Govish/FusIon-Pack/README.md

# FusIon-Pack
Design files and documentation for the FusIon Battery Pack
