Govish/FusIon-Pack/REV 0-1 PCB/Renderings/Front 3-4 Pre Silk 2-18.png

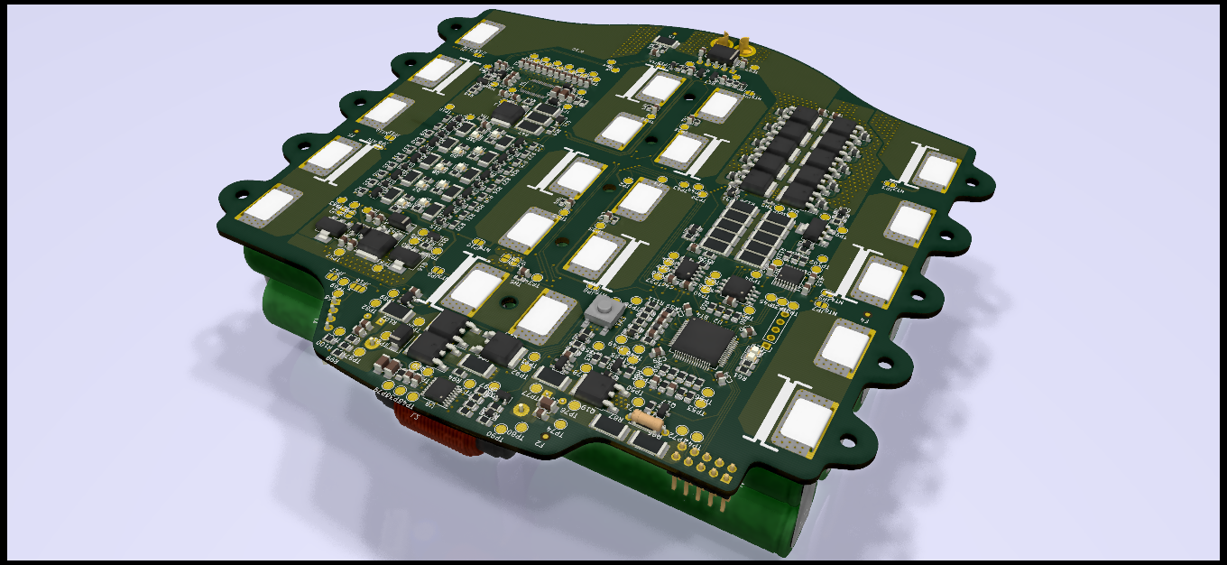
REV 0-1 PCB/Renderings/Front 3-4 Pre Silk 2-18.png
