Govish/FusIon-Pack/Bill of Materials/FusIon Pack.xlsx

Designator | Package | Quantity | Price @Break | Total Price | Value | Manufacturer | Part Number | Supplier and ref | Notes For Substitution
R78 | 1/4W Axial | 1 |  | $0.00 | DNP |  | - | - | Axial Resistor for alternative LED Button Voltage
R88 | 0805 | 1 |  | $0.00 | R |  | - | - | Compensation resistor, will figure out value
R94 | 0805 | 1 |  | $0.00 | 15R |  | - | - | Opt. Gate resistor for boost converter, pretty much anything tbh
C50, C51 | 1206 | 2 |  | $0.00 | C |  |  | - | Compensation capacitors, will figure out value
BT1, BT2, BT3, BT4, BT5, BT6, BT7, BT8, BT9, BT10 | Battery_18650_Cell_Pair | 10 | $8.50 | $85.00 | VTC4 | Sony | US18650VTC4 | 18650 Battery Store (https://www.18650batterystore.com/Sony-18650-p/sony-vtc4.htm) | Another VTC4 Supplier (e.g. IMR Batteries) (https://www.imrbatteries.com/murata-vtc4-18650-2100mah-30a-battery/)
C13, C14, C23, C24, C58, C62, C31 | 0805 | 7 | $0.50 | $3.50 | 1u | TDK Corporation | C2012X7S2A105K125AE | DigiKey (https://www.digikey.com/product-detail/en/tdk-corporation/C2012X7S2A105K125AE/445-8887-1-ND/3283749) | >=75V, X7R+ Rating preferrable (X5R probably would work)
C15, C16, C25, C26, C33, C35, C36, C37, C38, C39, C40, C41, C48, C59, C61, C63 | 0805 | 16 | $0.04 | $0.69 | 10n | Wurth Electronics | 885342207005 | DigiKey (https://www.digikey.com/product-detail/en/wurth-electronics-inc/885342207005/732-12105-1-ND/9346125) | >=75V, X7R+ Rating preferrable (X5R probably would work)
C17, C18, C1, C2, C3, C4, C5, C6, C7, C8, C9, C10, C11, C12, C21, C28, C29, C30, C32, C42, C43, C46, C47, C49, C53, C55, C60, C64, C65, C66, C67 | 0805 | 31 | $0.06 | $1.92 | 100n | Samsung Electro-Mechanics | CL21B104KBFNNNE | DigiKey (https://www.digikey.com/product-detail/en/samsung-electro-mechanics/CL21B104KBFNNNE/1276-1180-1-ND/3889266) | >50V, X7R+ Rating preferrable (X5R probably would work)
C19, C20, C54 | 1206 | 3 | $0.57 | $1.71 | 10u | Murata | GRT31CR61H106ME01L | DigiKey (https://www.digikey.com/product-detail/en/murata-electronics-north-america/GRT31CR61H106ME01L/490-12457-1-ND/5417158) | 35V absolute minimum, >=50V preferrable; X7R+ Rating preferrable (X5R possible?)
C22, C27, C34, C44, C45, C56 | 0805 | 6 | $0.13 | $0.78 | 4.7u | Samsung Electro-Mechanics | CL21A475KPFNNNE | DigiKey (https://www.digikey.com/product-detail/en/samsung-electro-mechanics/CL21A475KPFNNNE/1276-1259-1-ND/3889345) | >=10V abs min, X7R+ Rating preferrable (X5R probably would work)
C52, C57 | CP_Radial_D8.0mm_P3.50mm_H13.0mm | 2 | $2.60 | $5.20 | 33u | Nichicon | RNU1J330MDN1KX | DigiKey (https://www.digikey.com/product-detail/en/nichicon/RNU1J330MDN1KX/493-6639-1-ND/3466033) | >=63V, <76mOhm ESR, >32uF, Iripple >2.12A, self resonant frequency >150kHz
D1, D2, D3, D4, D5, D6, D7, D8, D9, D10, D28, D29 | 0805 | 12 | $0.18 | $2.16 | RED | Wurth Electronics | 150080RS75000 | DigiKey (https://www.digikey.com/product-detail/en/wurth-electronics-inc/150080RS75000/732-4984-1-ND/4489916) | Vf ~2V
D11, D12, D13, D14, D15, D16, D17, D18, D19, D20, D24, D26, D27, D32, D35, D38 | SOD-323 | 16 | $0.14 | $2.29 | 5.1V | ON Semiconductor | MM3Z5V1ST1G | DigiKey (https://www.digikey.com/product-detail/en/on-semiconductor/MM3Z5V1ST1G/MM3Z5V1ST1GOSCT-ND/964547) | <Vgs of balance FETS (4.2-6.2V); 300mW
D25, D31, D30, D21, D23, D22 | SOD-123 | 6 | $0.14 | $0.84 | 1N4448 | Micro Commercial Co | 1N4448W-TP | DigiKey (https://www.digikey.com/product-detail/en/micro-commercial-co/1N4448W-TP/1N4448WTPMSCT-ND/789337) | >250mA Forward Current Rated, 75V or more reverse
D34 | D_SMA | 1 | $0.43 | $0.43 | 5A, 50V | Vishay Semiconductor | VSSAF510-M3/H | DigiKey (https://www.digikey.com/product-detail/en/vishay-semiconductor-diodes-division/VSSAF510-M3-H/VSSAF510-M3-HGICT-ND/9601403) | 5A If, 50V Vr, Shottky, Low Vf Preferrable
D39, D33, D36, D40, D41 | SOD-323 | 5 | $0.18 | $0.90 | 12V | Nexperia | PDZ12BGWJ | DigiKey (https://www.digikey.com/product-detail/en/nexperia-usa-inc/PDZ12BGWJ/1727-7763-1-ND/8640744) | 10-15V (less than Vgs_max of FETs), 365mW or better power rating
D42 | D_SMC | 1 | $0.66 | $0.66 | 58V TVS | SMC Diode Solutions | 3.0SMI58ATR | DigiKey (https://www.digikey.com/product-detail/en/smc-diode-solutions/3.0SMI58ATR/1655-2077-1-ND/9566395) | So I'm not 100% sure, Vr 55~60V, >=1.8kW Peak Power Pulse (look at TI application circuit for BQ76930 for an idea)
D43 | D_SMA | 1 | $0.46 | $0.46 | 6.2V | Micro Commercial Co | SMAJ5920B-TP | DigiKey (https://www.digikey.com/product-detail/en/micro-commercial-co/SMAJ5920B-TP/SMAJ5920BTPMSCT-ND/1114257) | 6.2V, >=1.5W Rated Power
J1 | PinHeader_2x05_P2.54mm_Vertical | 1 | $0.27 | $0.27 | 05x02 | Sullins Connector Solutions | PREC005DFAN-RC | DigiKey (https://www.digikey.com/product-detail/en/sullins-connector-solutions/PREC005DFAN-RC/S2212EC-05-ND/2775009) | Literally anything tbh
J3 | 04x2.5mm Header | 1 | $0.21 | $0.21 | B4B-XH-A(LF)(SN) | Japan Solderless Terminals | B4B-XH-A(LF)(SN) | DigiKey (https://www.digikey.com/product-detail/en/jst-sales-america-inc/B4B-XH-A-LF-SN/455-2249-ND/1651047) | 4-pin JST-XH connector (just like for 3S LiPo balance connector)
J4 | 05x2.5mm Header | 1 | $0.25 | $0.25 | B5B-XH-A(LF)(SN) | Japan Solderless Terminals | B5B-XH-A(LF)(SN) | DigiKey (https://www.digikey.com/product-detail/en/jst-sales-america-inc/B5B-XH-A-LF-SN/455-2270-ND/1530483) | 5-pin JST-XH connector (just like for 4S LiPo balance connector)
L1, L3, L4, L5, L6, L7, L8, L9, L10, L11, L12 | 0805 | 11 | $0.04 | $0.44 | 600 ohm | Abracon LLC | ACML-0805-601-T | DigiKey (https://www.digikey.com/product-detail/en/abracon-llc/ACML-0805-601-T/535-12556-1-ND/4864699) | 100mA DC capable; approximately 600 Ohm @100MHz (not super critical)
L2 | L_Axial_L31.75mm_D14.22mm_P36mm_Bourns | 1 | $2.14 | $2.14 | 68uH | Bourns Inc. | 5248-RC | DigiKey (https://www.digikey.com/product-detail/en/bourns-inc/5248-RC/M8270-ND/774810) | Average Current Rating >5A; Saturation Current >5.5A (tested at 150kHz ideally)
R1, R3, R5, R7, R9, R11, R13, R15, R17, R19, R61, R62, R101 | 0805 | 13 | $0.02 | $0.26 | 390R | Stackpole Electronics | RMCF0805JT390R | DigiKey (https://www.digikey.com/product-detail/en/stackpole-electronics-inc/RMCF0805JT390R/RMCF0805JT390RCT-ND/1942549) | 5% Tolerance or Better
R107 | 2512 | 1 | $0.92 | $0.92 | 2mR 5W 1% 70ppm | Vishay Dale | WSLF25122L000FEB | DigiKey (https://www.digikey.com/product-detail/en/vishay-dale/WSLF25122L000FEB/541-3131-1-ND/6194704) | ~4W Min, 1%, <75ppm/C temp co ideally
R109, R116, R123 | 0805 | 3 | $0.03 | $0.10 | 10M | Stackpole Electronics | RMCF0805JT10M0 | DigiKey (https://www.digikey.com/product-detail/en/stackpole-electronics-inc/RMCF0805JT10M0/RMCF0805JT10M0CT-ND/1942604) | Basically anything really
R2, R4, R6, R8, R10, R12, R14, R16, R18, R20, R79 | 2010 | 11 | $0.19 | $2.10 | 36R 3/4W | Stackpole Electronics | RMCF2010JT36R0 | DigiKey (https://www.digikey.com/product-detail/en/stackpole-electronics-inc/RMCF2010JT36R0/RMCF2010JT36R0CT-ND/6053373) | 5% Tolerance or Better, >=0.6W
R21, R23, R25, R27, R29, R31, R32, R34, R36, R38, R40, R42, R43, R55, R56, R68, R82, R85, R100, R104, R108, R130 | 0805 | 22 | $0.03 | $0.59 | 1K | Stackpole Electronics | RMCF0805FT1K00 | DigiKey (https://www.digikey.com/product-detail/en/stackpole-electronics-inc/RMCF0805FT1K00/RMCF0805FT1K00CT-ND/1942370) | 1% Tolerance or Better
R44, R45, R50, R58, R66, R74, R77, R83, R84, R89, R90, R91, R96, R98, R99, R103, R105, R113 | 0805 | 18 | $0.03 | $0.49 | 100K | Stackpole Electronics | RMCF0805FT100K | DigiKey (https://www.digikey.com/product-detail/en/stackpole-electronics-inc/RMCF0805FT100K/RMCF0805FT100KCT-ND/1942491) | 1% Tolerance or Better
R46, R47, R51, R86, R87, R117, R118, R119, R120, R121, R124, R125, R126, R127, R128 | 2512 | 15 | $0.25 | $3.81 | 200R 1W | Stackpole Electronics | RMCF2512JT200R | DigiKey (https://www.digikey.com/product-detail/en/stackpole-electronics-inc/RMCF2512JT200R/RMCF2512JT200RCT-ND/2419087) | >= 1W
R52, R53, R75, R76, R81, R106, R110, R115, R122, R129 | 0805 | 10 | $0.02 | $0.20 | 100R | Stackpole Electronics | RMCF0805JT100R | DigiKey (https://www.digikey.com/product-detail/en/stackpole-electronics-inc/RMCF0805JT100R/RMCF0805JT100RCT-ND/1942539) | >=1/10W, pretty much anything tbh
R54, R22, R24, R26, R28, R30, R33, R35, R37, R39, R41, R48, R49, R57, R59, R60, R63, R64, R65, R67, R69, R70, R71, R72, R73, R80, R93, R97, R111, R112, R114 | 0805 | 31 | $0.03 | $0.84 | 10K | Stackpole Electronics | RMCF0805FT10K0 | DigiKey (https://www.digikey.com/product-detail/en/stackpole-electronics-inc/RMCF0805FT10K0/RMCF0805FT10K0CT-ND/1942435) | 1% Rated
R92, R95, R102 | 2512 | 3 | $0.57 | $1.71 | 20mR 3/4W | Yageo | PE2512FKE7W0R02L | DigiKey (https://www.digikey.com/product-detail/en/yageo/PE2512FKE7W0R02L/YAG2170CT-ND/5139618) | >=0.75W, 1%, <75ppm/C temp co ideally
SW1 | SW_SPST_PTS641 | 1 | $0.28 | $0.28 | SW_Push | C&K | PTS641SP25SMTR2LFS | DigiKey (https://www.digikey.com/product-detail/en/c-k/PTS641SP25SMTR2LFS/CKN10812CT-ND/7056105) | Only for development--doesn't clear case lid
TH1, TH2, TH3, TH4, TH5, TH6, TH7 | 0603 | 7 | $0.17 | $1.22 | 10K | Panasonic Electronic Components | ERT-J1VR103G | DigiKey (https://www.digikey.com/product-detail/en/panasonic-electronic-components/ERT-J1VR103G/P124026CT-ND/9646660) | B25/50 = 4250K w/o configuration, +/- 2% tolerance on beta and R25 preferrable
U2 | LQFP-64 | 1 | $4.21 | $4.21 | STM32F072RBTx | ST Microelectronics | STM32F072RBT6 | DigiKey (https://www.digikey.com/product-detail/en/STM32F072RBT6/497-14644-ND/4815291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) | If ST makes pin compatible, peripheral compatible microcontrollers, it might work (may require code adaptation)
U3 | TO-252-2 | 1 | $0.66 | $0.66 | L7805 | ON Semiconductor | MC7805CD2TG | DigiKey (https://www.digikey.com/product-detail/en/on-semiconductor/MC7805CD2TG/MC7805CD2TGOS-ND/1481215) | 7805 Compatible footprint, >=15Vin, 5Vout, 250mA continuous output current, stable w/ ceramic caps
U6 | SOIC-8 (5.3mm) | 1 | $0.49 | $0.49 | W25Q16JVSSIQ | Winbond Electronics | W25Q16JVSSIQ | DigiKey (https://www.digikey.com/product-detail/en/winbond-electronics/W25Q16JVSSIQ/W25Q16JVSSIQ-ND/6193769) | 16MBit, Same pinout, Same functionality, ~8MHz SPI Capable
U8 | TSSOP-16_EP | 1 | $6.00 | $6.00 | LTC3783 | Linear Technology | LTC3783EFE#PBF | DigiKey (https://www.digikey.com/product-detail/en/linear-technology-analog-devices/LTC3783EFE-PBF/LTC3783EFE-PBF-ND/1620122) | -
J5 | XT-60_male | 1 | $0.45 | $0.45 | XT60 | Changzhou Amass Elec. | XT60-F | LCSC (https://lcsc.com/product-detail/Connectors_Changzhou-Amass-Elec-XT60Female_C98734.html?manu_id=1029) | Pretty much any XT60 from RC hobby retailers
F1 | Fuse_1025HCxx-RTR | 1 | $4.78 | $4.78 | 40A Fuse | Littelfuse | 0456040.DR | Mouser (https://www.mouser.com/ProductDetail/Littelfuse/0456040DR) | Something just like this (https://www.mouser.com/ProductDetail/Bussmann-Eaton/1025HC40-RTR)
Q12, Q1, Q2, Q3, Q4, Q5, Q6, Q7, Q8, Q9, Q10, Q13, Q14, Q15, Q17, Q18, Q21 | SOT-23 | 17 | $0.14 | $2.29 | RUC002N05HZGT116 | Rohm Semiconductor | RUC002N05HZGT116 | Mouser (https://www.mouser.com/ProductDetail/ROHM-Semiconductor/RUC002N05HZGT116) | >=50Vds min, defined Rds_on at 1.5V gate drive, 120mA Id with Ta = 45C
Q16, Q34 | SOT-223 | 2 | $0.57 | $1.14 | FQT5P10TF | ON Semiconductor | FQT5P10TF | Mouser (https://www.mouser.com/ProductDetail/ON-Semiconductor-Fairchild/FQT5P10TF) | >=75Vds, Vgs < 12V, 250mA Id continuous, 1A Id for several seconds
Q19, Q22, Q23 | TO-252-2 | 3 | $0.61 | $1.83 | DMPH6050SK3 | Diodes Incorporated | DMPH6050SK3-13 | Mouser (https://www.mouser.com/ProductDetail/Diodes-Incorporated/DMPH6050SK3-13) | >=60Vds, <=~80mOhm RdsOn, >=12Vgs
Q28, Q24, Q11, Q20, Q25, Q26, Q27, Q29, Q30, Q31, Q32, Q33 | TO-252-2 (D-PAK) | 12 | $0.98 | $11.75 | IPD60N10S4L-12 | Infineon Technologies | IPD60N10S4L12ATMA1 | Mouser (https://www.mouser.com/ProductDetail/Infineon-Technologies/IPD60N10S4L12ATMA1) | >~75Vds, Similar Rds_on or lower, Similar Vgs_th or lower, Similar Qg or lower
U1 | TSSOP-30 | 1 | $4.66 | $4.66 | BQ76930 | Texas Instruments | BQ7693006DBTR | Mouser (https://www.mouser.com/ProductDetail/Texas-Instruments/BQ7693006DBTR) | BQ7693000DBT[R]; BQ7693002DBT[R]; BQ7693006DBT[R]; (LDO Voltage shouldn't matter, Different I2C Addresses)
U10 | TSSOP-16 | 1 | $2.33 | $2.33 | BQ76200 | Texas Instruments | BQ76200PWR | Mouser (https://www.mouser.com/ProductDetail/Texas-Instruments/BQ76200PWR) | -
U4 | SOT-223 | 1 | $0.36 | $0.36 | AP2114H-3.3TRG1 | Diodes Incorporated | AP2114H-3.3TRG1 | Mouser (https://www.mouser.com/ProductDetail/Diodes-Incorporated/AP2114H-33TRG1) | >=5Vin, 250mA continuous output, 1117 regulator compatible, stable with ceramic in/output caps
U5 | SOIC-8 | 1 | $0.54 | $0.54 | ATA6561 | Microchip Technology | ATA6561-GAQW-N | Mouser (https://www.mouser.com/ProductDetail/Microchip-Technology-Atmel/ATA6561-GAQW-N) | Same pinout, same functionality (e.g. TCAN1042VDRQ1) (https://www.mouser.com/ProductDetail/Texas-Instruments/TCAN1042VDRQ1)
U7, U9 | SOT-25 | 2 | $1.47 | $2.94 | ZXCT108x | Diodes Incorporated | ZXCT1084E5TA | Mouser (https://www.mouser.com/ProductDetail/Diodes-Incorporated/ZXCT1084E5TA) | >=42V common mode MINIMUM; 25x gain; same pinout
 |  |  | BOM Total | $166.80
 |  |  | w/o Batteries | $81.80
