Govish/FusIon-Pack/Documentation/Estimated BOM Cost.xlsx

Fusion Pack BOM
ITEM NAME | QTY | UNIT COST | TOTAL COST | Total BOM Cost
220n >25V CERAMIC CAPACITOR | 10 | $0.09 | $0.93 | $74.82
 |  |  | $0.00
 |  |  | $0.00
 |  |  | $0.00
 |  |  | $0.00
RED LED | 12 | $0.18 | $2.16
5.1V ZENER DIODE | 16 | $0.16 | $2.56
12V ZENER DIODE | 5 | $0.15 | $0.75
TVS DIODE - POWER STAGE | 2 | $0.66 | $1.32
BOOST DIODE | 1 | $0.43 | $0.43
AFE + REGULATOR RECTIFIERS | 6 | $0.14 | $0.84
 |  |  | $0.00
JST-XH FOR LED BUTTON | 1 | $0.14 | $0.14
XT-60 | 1 | $0.50 | $0.50
5X2 HEADER USB BOARD | 1 | $0.27 | $0.27
3X2 HEADER POWER BOARD | 1 | $0.18 | $0.18
 |  |  | $0.00
FERRITE BEAD | 11 | $0.04 | $0.44
BOOST INDUCTOR | 1 | $4.38 | $4.38
 |  |  | $0.00
RUC-XXX LV N-MOS | 17 | $0.19 | $3.23
IPD60N10S4L POWER N-MOS | 12 | $1.23 | $14.74
FQT5P10TF LOW POWER P-MOS | 2 | $0.70 | $1.40
IRF5210 | 3 | $2.75 | $8.25
 |  |  | $0.00
390R RESISTOR | 13 | $0.02 | $0.26
36R RESISTOR | 11 | $0.19 | $2.10
1K 1% RESISTOR | 21 | $0.03 | $0.57
10K 1% RESISTOR | 31 | $0.03 | $0.84
100K 1% RESISTOR | 18 | $0.03 | $0.49
100R RESISTOR | 10 | $0.02 | $0.20
10 MEG RESISTOR | 3 | $0.07 | $0.20
200R 1W RESISTOR | 15 | $0.25 | $3.81
 |  |  | $0.00
NTC THERMISTOR | 7 | $0.17 | $1.22
 |  |  | $0.00
PUSHBUTTON | 1 | $0.28 | $0.28
 |  |  | $0.00
MC7805CD2TG | 1 | $0.66 | $0.66
BQ76930 | 1 | $4.80 | $4.80
STM32F072RB | 1 | $3.83 | $3.83
AP2114 3V3 REGULATOR | 1 | $0.37 | $0.37
ATA6561-GAQW | 1 | $0.55 | $0.55
W25Q16JVSSIQ | 1 | $0.49 | $0.49
ZXCT1084 | 2 | $1.62 | $3.24
LTC3783 | 1 | $6.00 | $6.00
BQ76200 | 1 | $2.41 | $2.41
