Govish/FusIon-Pack/REV 0-2 PCB/FlatPack 0-2/FlatPack 0-2 BOM.xlsx

Sheet: Complete BOM
Package | Quantity | Price @Break | Total Price | Value | Manufacturer | Part Number | Supplier and Ref | Notes for Substitution
TO-252-2 | 1 | $0.59 | $0.59 | LD-1117 | Diodes Inc. | ZLDO1117K33TC | DigiKey (https://www.digikey.com/product-detail/en/diodes-incorporated/ZLDO1117K33TC/ZLDO1117K33DICT-ND/2095619) | Any regulator that has <1.7V dropout and is stable with low-value ceramic caps | Ordered
JST-XH | 1 | $0.50 | $0.50 | Conn_01x11 | JST Sales America | B11B-XH-A(LF)(SN) | DigiKey (https://www.digikey.com/product-detail/en/jst-sales-america-inc/B11B-XH-A-LF-SN/455-2255-ND/1651053) | Any reasonable battery balance connector (must handle balance current) | On Hand
SOIC-14 | 1 | $0.70 | $0.70 | ATtiny24 | Microchip Technology | ATTiny24A-SSU | DigiKey (https://www.digikey.com/product-detail/en/microchip-technology/ATTINY24A-SSU/ATTINY24A-SSU-ND/2050982) | Any part from the ATTinyX4 series with the same package | Sampled
0805 | 5 | $0.14 | $0.71 | 4u7 | MuRata Electronics | GRM21BR71C475KE51L | DigiKey (https://www.digikey.com/product-detail/en/murata-electronics/GRM21BR71C475KE51L/490-14466-1-ND/6606927) | >=10V abs min, X7R+ Rating preferrable (X5R probably would work)
SOD-323 | 5 | $0.16 | $0.79 | 12V | Nexperia | PDZ12BGWJ | DigiKey (https://www.digikey.com/product-detail/en/nexperia-usa-inc/PDZ12BGWJ/1727-7763-1-ND/8640744) | 10-15V (less than Vgs_max of FETs), 365mW or better power rating
CP_Radial_D10.0mm_P5.00mm | 1 | $2.97 | $2.97 | 47u | Nichicon | PLV1J470MDL1 | DigiKey (https://www.digikey.com/product-detail/en/nichicon/PLV1J470MDL1/493-14185-ND/4991366) | 40uF+, 63V+, 2.125A+ Ripple Rating, <= 73mOhm ESR
SOD-323 | 5 | $0.10 | $0.48 | 100V 200mA | On Semiconductor | BAS16HT3G | DigiKey (https://www.digikey.com/product-detail/en/on-semiconductor/BAS16HT3G/BAS16HT3GOSCT-ND/9086375) | >=75V reverse, 100mA If
TO-252-2 | 3 | $1.57 | $4.71 | FDD86367 | On Semiconductor | FDD86367-F085 | DigiKey (https://www.digikey.com/product-detail/en/on-semiconductor/FDD86367-F085/FDD86367-F085CT-ND/5289188) | >=60Vds min, <~6mOhom or better RdsOn
SOD-323 | 12 | $0.12 | $1.46 | 5.1V | On Semiconductor | MM3Z5V1ST1G | DigiKey (https://www.digikey.com/product-detail/en/on-semiconductor/MM3Z5V1ST1G/MM3Z5V1ST1GOSCT-ND/964547) | <Vgs of balance FETS (4.2-6.2V); 300mW
SOT-23-3 | 1 | $0.38 | $0.38 | PACDN042 | On Semiconductor | PACDN042Y3R | DigiKey (https://www.digikey.com/product-detail/en/on-semiconductor/PACDN042Y3R/PACDN042Y3ROSCT-ND/3487662) | Any sort of dual diode package that clamps a little bit higher than 5V
SOT-23-3 | 1 | $0.38 | $0.38 | SESDONCAN1LT1G | On Semiconductor | SESDONCAN1LT1G | DigiKey (https://www.digikey.com/product-detail/en/on-semiconductor/SESDONCAN1LT1G/SESDONCAN1LT1GOSCT-ND/9087728) | Any Bidirectional CAN ESD supressor that can protect the CAN transceiver
2512 | 1 | $0.71 | $0.71 | 1mR | Riedon | CSR2512C0R001F | DigiKey (https://www.digikey.com/product-detail/en/riedon/CSR2512C0R001F/696-1185-1-ND/2813309) | >2W, 3W preferrable at least, 75ppm/C or better
SOT-23-5 | 15 | $0.17 | $2.49 | RUC002N05HZGT116 | Rohm Semiconductor | RUC002N05HZGT116 | DigiKey (https://www.digikey.com/product-detail/en/rohm-semiconductor/RUC002N05HZGT116/RUC002N05HZGT116CT-ND/8026658) | >=50Vds min, defined Rds_on at 1.5V gate drive, 120mA Id with Ta = 45C
0603 | 11 | $0.05 | $0.52 | 10n | Samsung Electro-Mechanics | CL10B103KC8NNNC | DigiKey | >=75V, X7R+ Rating preferrable (X5R probably would work)
0603 | 33 | $0.03 | $0.92 | 100n | Samsung Electro-Mechanics | CL10B104KB8NNNC | DigiKey (https://www.digikey.com/product-detail/en/samsung-electro-mechanics/CL10B104KB8NNNC/1276-1000-1-ND/3889086) | >50V, X7R+ Rating preferrable (X5R probably would work)
1206 | 4 | $0.21 | $0.83 | 10u | Samsung Electro-Mechanics | CL31A106MBHNNNE | DigiKey | 35V absolute minimum, >=50V preferrable; X7R+ Rating preferrable (X5R possible?)
2010 | 10 | $0.19 | $1.91 | 36R | Stackpole Electronics | RMCF2010JT36R0 | DigiKey (https://www.digikey.com/product-detail/en/stackpole-electronics-inc/RMCF2010JT36R0/RMCF2010JT36R0CT-ND/6053373) | 5% tolerance-ish, >0.6W
2512 | 6 | $0.30 | $1.80 | 200R 1W | Stackpole Electronics | RMCF2512JT200R | DigiKey (https://www.digikey.com/product-detail/en/stackpole-electronics-inc/RMCF2512JT200R/RMCF2512JT200RCT-ND/2419087) | >=1W
Nonstandard | 1 | $1.04 | $1.04 | 22uH | Sumida | 104CDMCCDS-220MC | DigiKey (https://www.digikey.com/product-detail/en/sumida-america-components-inc/104CDMCCDS-220MC/308-2498-1-ND/9490545) | 22uH, >=5A saturation and operating current rating
Nonstandard | 1 | $0.45 | $0.45 | 47uH | Taiyo Yuden | NR4018T470M | DigiKey (https://www.digikey.com/product-detail/en/taiyo-yuden/NR4018T470M/587-1670-1-ND/1008285) | Any sort of 47uH inductor with >500mA current rating (check calculator for confirmation)
0805 | 11 | $0.30 | $3.27 | 1u | TDK Corporation | C2012X7S2A105M125AE | DigiKey (https://www.digikey.com/product-detail/en/tdk-corporation/C2012X7S2A105M125AE/445-6804-1-ND/2616435) | >=75V, X7R+ Rating preferrable (X5R probably would work)
TO-252-2 | 2 | $1.33 | $2.66 | TK7S10N1Z | Toshiba Semiconductor | TK7S10N1Z,LQ | DigiKey (https://www.digikey.com/product-detail/en/toshiba-semiconductor-and-storage/TK7S10N1ZLQ/TK7S10N1ZLQCT-ND/4815244) | Switch FET, Low Qg, >=60Vds, run through calculator to make sure
SMA | 1 | $0.39 | $0.39 | 5A >50V | Vishay Semiconductor | VSSAF510-M3/H | DigiKey (https://www.digikey.com/product-detail/en/vishay-semiconductor-diodes-division/VSSAF510-M3-H/VSSAF510-M3-HGICT-ND/9601403) | 5A If, 50V Vr, Shottky, Low Vf Preferrable
Vishay_PowerPAK_1212-8_Single | 3 | $1.10 | $3.30 | SQJ479EP | Vishay Siliconix | SQJ479EP-T1_GE3 | DigiKey (https://www.digikey.com/product-detail/en/vishay-siliconix/SQJ479EP-T1_GE3/SQJ479EP-T1_GE3CT-ND/6708994) | >=60Vds min, <50mOhm RdsOn
SOIC-8_W | 1 | $0.49 | $0.49 | W25Q16JVSSIQ | Winbond Electronics | W25Q16JVSSIQ | DigiKey (https://www.digikey.com/product-detail/en/winbond-electronics/W25Q16JVSSIQ/W25Q16JVSSIQ-ND/6193769) | 16MBit, Same pinout, Same functionality, ~8MHz SPI Capable
0603 | 5 | $0.17 | $0.85 | 600R | Wurth Electronics | 742792651 | DigiKey (https://www.digikey.com/product-detail/en/wurth-electronics-inc/742792651/732-1593-1-ND/1639537) | 100mA DC capable; approximately 600 Ohm @100MHz (not super critical)
0603 | 15 | $0.14 | $2.10 | RED | Wurth Electronics | 150060RS75000 | DigiKey (https://www.digikey.com/product-detail/en/wurth-electronics-inc/150060RS75000/732-4978-1-ND/4489899) | Vf ~2V
2512 | 2 | $0.74 | $1.48 | 20mR 3/4W | Yageo | PE2512FKE7W0R02L | DigiKey (https://www.digikey.com/product-detail/en/yageo/PE2512FKE7W0R02L/YAG2170CT-ND/5139618) | >=0.75W, 1%, <75ppm/C temp co ideally
0603 | 13 | $0.01 | $0.13 | 100R | Yageo | RC0603FR-07100RL | DigiKey (https://www.digikey.com/product-detail/en/yageo/RC0603FR-07100RL/311-100HRCT-ND/729835) | 1% tolerance or better
0603 | 27 | $0.01 | $0.26 | 10K | Yageo | RC0603FR-0710KL | DigiKey (https://www.digikey.com/product-detail/en/yageo/RC0603FR-0710KL/311-10.0KHRCT-ND/729827) | 1% tolerance or better
0603 | 3 | $0.01 | $0.03 | 10M | Yageo | RC0603FR-0710ML | DigiKey (https://www.digikey.com/product-detail/en/yageo/RC0603FR-0710ML/311-10.0MHRCT-ND/729828) | 5% tolerance or better
0603 | 22 | $0.01 | $0.21 | 1K | Yageo | RC0603FR-071KL | DigiKey (https://www.digikey.com/product-detail/en/yageo/RC0603FR-071KL/311-1.00KHRCT-ND/729790) | 1% tolerance or better
0603 | 9 | $0.01 | $0.09 | 240K | Yageo | RC0603FR-07240KL | DigiKey (https://www.digikey.com/product-detail/en/yageo/RC0603FR-07240KL/311-240KHRCT-ND/730029) | 1% tolerance or better
0603 | 4 | $0.01 | $0.04 | 33K | Yageo | RC0603FR-0733KL | DigiKey (https://www.digikey.com/product-detail/en/yageo/RC0603FR-0733KL/311-33.0KHRCT-ND/730106) | 1% tolerance or better
0603 | 1 | $0.02 | $0.02 | 36R | Yageo | RC0603FR-0736RL | DigiKey (https://www.digikey.com/product-detail/en/yageo/RC0603FR-0736RL/311-36.0HRCT-ND/730125) | 1% tolerance or better
0603 | 13 | $0.01 | $0.13 | 390R | Yageo | RC0603FR-07390RL | DigiKey (https://www.digikey.com/product-detail/en/yageo/RC0603FR-07390RL/311-390HRCT-ND/730145) | 1% tolerance or better
SW_SPST_PTS641 | 1 | $0.27 | $0.27 | SW_Push | C&K | PTS641SP25SMTR2LFS | DigiKey (https://www.digikey.com/product-detail/en/c-k/PTS641SP25SMTR2LFS/CKN10812CT-ND/7056105) | Some generic pushbutton switch
SOT-23-6 | 1 | $2.24 | $2.24 | MCP3425A0T-ECH | Microchip Technology | MCP3425A0T-ECH | DigiKey (https://www.digikey.com/product-detail/en/microchip-technology/MCP3425A0T-E-CH/MCP3425A0T-E-CHCT-ND/1979810) | Some sort of 12+ Bit I2C Differential ADC; PGA is nice
0.1" Header | 5 | $0.00 | $0.00 | Conn_01x40 | Generic | NA | - | Any sort of 0.1" header for prototyping
TSSOP-16-EP | 1 | $6.91 | $6.91 | LTC3783 | Linear Technology | LTC3783EFE#PBF | DigiKey (https://www.digikey.com/product-detail/en/linear-technology-analog-devices/LTC3783EFE-PBF/LTC3783EFE-PBF-ND/1620122) | -
Fuse_1025HCxx-RTR | 1 | $4.78 | $4.78 | 40A | Littelfuse | 0456040.DR | DigiKey (https://www.digikey.com/product-detail/en/littelfuse-inc/0456040.DR/F3364CT-ND/2080265) | Something like this (https://www.digikey.com/product-detail/en/eaton-electronics-division/1025HC40-RTR/283-4681-1-ND/6187865)
SOIC-8 | 1 | $0.55 | $0.55 | ATA6561 | Microchip Technology | ATA6561-GAQW-N | DigiKey (https://www.digikey.com/product-detail/en/microchip-technology/ATA6561-GAQW-N/ATA6561-GAQW-NCT-ND/9453180) | Same pinout, same functionality (e.g. TCAN1042VDRQ1) (https://www.digikey.com/product-detail/en/texas-instruments/TCAN1042VDRQ1/296-46214-1-ND/7033389)
SOT-23-6 | 1 | $1.70 | $1.70 | MCP6C02_xxx | Microchip Technology | MCP6C02T-050E/CHY | DigiKey (https://www.digikey.com/product-detail/en/microchip-technology/MCP6C02T-050E-CHY/MCP6C02T-050E-CHYCT-ND/9757867) | Any part in the family *should* work
SOD-123 | 1 | $0.35 | $0.35 | 80V | MicroCommercial Devices | MBR0580-TP | DigiKey (https://www.digikey.com/product-detail/en/micro-commercial-co/MBR0580-TP/MBR0580-TPMSCT-ND/2423306) | >50V reverse, forward current should be >500mA
SMC | 1 | $0.56 | $0.56 | 58V TVS | SMC Diode Solutions | 3.0SMI58ATR | DigiKey (https://www.digikey.com/product-detail/en/smc-diode-solutions/3.0SMI58ATR/1655-2077-1-ND/9566395) | So I'm not 100% sure, Vr 55~60V, >=1.8kW Peak Power Pulse (look at TI application circuit for BQ76930 for an idea)
TSSOP-16 | 1 | $2.41 | $2.41 | BQ76200 | Texas Instruments | BQ76200PWR | DigiKey | -
TSSOP-30 | 1 | 4.8 | 4.8 | BQ76930 | Texas Instruments | BQ7693006DBTR | DigiKey (https://www.digikey.com/product-detail/en/texas-instruments/BQ7693006DBTR/296-39962-1-ND/5177839) | BQ7693002 (https://www.digikey.com/product-detail/en/texas-instruments/BQ7693002DBT/296-43250-5-ND/5765936)
SOT-23-5 | 1 | 0.59 | 0.59 | INA180B | Texas Instruments | INA180A1IDBVT | DigiKey (https://www.digikey.com/product-detail/en/texas-instruments/INA180A1IDBVT/296-46627-1-ND/7219063) | Same pinout, 20-25V/V, 20V+ input
SOT-23-6 | 1 | 2.88 | 2.88 | LMR16006 | Texas Instruments | LMR16006XDDCR | DigiKey (https://www.digikey.com/product-detail/en/texas-instruments/LMR16006XDDCR/296-40293-1-ND/5178170) | Any X variant; Y variant may be used, but component values would need to be recalculated

Sheet: AFE SubBoard 0-2
AFE SubBoard Bill of Materials
Note that are calculated based on a "reasonable" amount of extras, i.e. if the BOM calls for 18 caps, I'll use the 25-of price break; price of the extras are not included in the total BOM cost
Reference Number | Package | Quantity | Price @Break | Total Price | Value | Manufacturer | Part Number | Supplier and Ref | Notes for Substitution
C1, C2, C3, C4, C12, C5, C6, C7, C8, C9, C11, C10, | 0603 | 12 | $0.03 | $0.34 | 100n | Samsung Electro-Mechanics | CL10B104KB8NNNC | DigiKey (https://www.digikey.com/product-detail/en/samsung-electro-mechanics/CL10B104KB8NNNC/1276-1000-1-ND/3889086) | >50V, X7R+ Rating preferrable (X5R probably would work)
C17, C16, C14, C13, | 0805 | 4 | $0.30 | $1.19 | 1u | TDK Corporation | C2012X7S2A105M125AE | DigiKey (https://www.digikey.com/product-detail/en/tdk-corporation/C2012X7S2A105M125AE/445-6804-1-ND/2616435) | >=75V, X7R+ Rating preferrable (X5R probably would work)
C18, | 0805 | 1 | $0.14 | $0.14 | 4u7 | MuRata Electronics | GRM21BR71C475KE51L | DigiKey (https://www.digikey.com/product-detail/en/murata-electronics/GRM21BR71C475KE51L/490-14466-1-ND/6606927) | >=10V abs min, X7R+ Rating preferrable (X5R probably would work)
C19, C20, C15, | 0603 | 3 | $0.05 | $0.14 | 10n | Samsung Electro-Mechanics | CL10B103KC8NNNC | DigiKey (https://www.digikey.com/product-detail/en/samsung-electro-mechanics/CL10B103KC8NNNC/1276-1196-1-ND/3889282) | >=75V, X7R+ Rating preferrable (X5R probably would work)
C21, C22, | 1206 | 2 | $0.21 | $0.42 | 10u | Samsung Electro-Mechanics | CL31A106MBHNNNE | DigiKey (https://www.digikey.com/product-detail/en/samsung-electro-mechanics/CL31A106MBHNNNE/1276-6736-1-ND/5961595) | 35V absolute minimum, >=50V preferrable; X7R+ Rating preferrable (X5R possible?)
D1, D2, D3, D4, D5, D6, D7, D8, D9, D10, | 0603 | 10 | $0.14 | $1.40 | RED | Wurth Electronics | 150060RS75000 | DigiKey (https://www.digikey.com/product-detail/en/wurth-electronics-inc/150060RS75000/732-4978-1-ND/4489899) | Vf ~2V
D11, D12, D13, D14, D15, D16, D17, D18, D19, D20, D24, | SOD-323 | 11 | $0.12 | $1.34 | 5.1V | On Semiconductor | MM3Z5V1ST1G | DigiKey (https://www.digikey.com/product-detail/en/on-semiconductor/MM3Z5V1ST1G/MM3Z5V1ST1GOSCT-ND/964547) | <Vgs of balance FETS (4.2-6.2V); 300mW
D22, D23, D21, D25, | SOD-323 | 4 | $0.10 | $0.39 | 100V 200mA | On Semiconductor | BAS16HT3G | DigiKey (https://www.digikey.com/product-detail/en/on-semiconductor/BAS16HT3G/BAS16HT3GOSCT-ND/9086375) | >=75V reverse, 100mA If
J1, | JST-XH | 1 | $0.50 | $0.50 | Conn_01x11 | JST Sales America | B11B-XH-A(LF)(SN) | DigiKey (https://www.digikey.com/product-detail/en/jst-sales-america-inc/B11B-XH-A-LF-SN/455-2255-ND/1651053) | Any reasonable battery balance connector (must handle balance current)
J3, | 0.1" Header | 1 | $0.00 | $0.00 | Conn_01x06 | Generic | NA | - | Any sort of 0.1" header for prototyping
J4, J2, | 0.1" Header | 2 | $0.00 | $0.00 | Conn_01x04 | Generic | NA | - | Any sort of 0.1" header for prototyping
Q1, Q2, Q3, Q4, Q5, Q6, Q7, Q8, Q9, Q10, Q11, Q12, | SOT-23-5 | 12 | $0.17 | $1.99 | RUC002N05HZGT116 | Rohm Semiconductor | RUC002N05HZGT116 | DigiKey (https://www.digikey.com/product-detail/en/rohm-semiconductor/RUC002N05HZGT116/RUC002N05HZGT116CT-ND/8026658) | >=50Vds min, defined Rds_on at 1.5V gate drive, 120mA Id with Ta = 45C
R1, R2, R3, R4, R5, R6, R7, R8, R9, R10, | 0603 | 10 | $0.01 | $0.10 | 390R | Yageo | RC0603FR-07390RL | DigiKey (https://www.digikey.com/product-detail/en/yageo/RC0603FR-07390RL/311-390HRCT-ND/730145) | 1% tolerance or better
R11, R12, R13, R14, R15, R16, R17, R18, R19, R20, | 2010 | 10 | $0.19 | $1.91 | 36R | Stackpole Electronics | RMCF2010JT36R0 | DigiKey (https://www.digikey.com/product-detail/en/stackpole-electronics-inc/RMCF2010JT36R0/RMCF2010JT36R0CT-ND/6053373) | 5% tolerance-ish, >0.6W
R22, R24, R26, R28, R30, R32, R36, R38, R40, R42, R44, R21, R33, R34, R46, | 0603 | 15 | $0.01 | $0.15 | 1K | Yageo | RC0603FR-071KL | DigiKey (https://www.digikey.com/product-detail/en/yageo/RC0603FR-071KL/311-1.00KHRCT-ND/729790) | 1% tolerance or better
R23, R25, R27, R29, R31, R35, R37, R39, R41, R43, R52, R48, R47, | 0603 | 13 | $0.01 | $0.13 | 10K | Yageo | RC0603FR-0710KL | DigiKey (https://www.digikey.com/product-detail/en/yageo/RC0603FR-0710KL/311-10.0KHRCT-ND/729827) | 1% tolerance or better
R49, R50, R45, R51, | 0603 | 4 | $0.01 | $0.04 | 240K | Yageo | RC0603FR-07240KL | DigiKey (https://www.digikey.com/product-detail/en/yageo/RC0603FR-07240KL/311-240KHRCT-ND/730029) | 1% tolerance or better
SW1, | SW_SPST_PTS641 | 1 | $0.27 | $0.27 | SW_Push | C&K | PTS641SP25SMTR2LFS | DigiKey (https://www.digikey.com/product-detail/en/c-k/PTS641SP25SMTR2LFS/CKN10812CT-ND/7056105) | Some generic pushbutton switch
U1 | TSSOP-30 | 1 | $4.80 | $4.80 | BQ76930 | Texas Instruments | BQ7693006DBTR | DigiKey (https://www.digikey.com/product-detail/en/texas-instruments/BQ7693006DBTR/296-39962-1-ND/5177839) | Any variant without CRC I2C communication and 3.3V regout
 |  | TOTAL COST |  | $15.23

Sheet: Button-Interface SubBoard 0-2
Reference Number | Package | Quantity | Price @Break | Total Price | Value | Manufacturer | Part Number | Supplier and Ref | Notes for Substitution
C2, C1, C3, C6, | 0603 | 4 | $0.03 | $0.11 | 100n | Samsung Electro-Mechanics | CL10B104KB8NNNC | DigiKey (https://www.digikey.com/product-detail/en/samsung-electro-mechanics/CL10B104KB8NNNC/1276-1000-1-ND/3889086) | >50V, X7R+ Rating preferrable (X5R probably would work)
C4, C7, C5, | 0603 | 3 | $0.05 | $0.14 | 10n | Samsung Electro-Mechanics | CL10B103KC8NNNC | DigiKey (https://www.digikey.com/product-detail/en/samsung-electro-mechanics/CL10B103KC8NNNC/1276-1196-1-ND/3889282) | >=75V, X7R+ Rating preferrable (X5R probably would work)
D1, | SOT-23-3 | 1 | $0.38 | $0.38 | PACDN042 | On Semiconductor | PACDN042Y3R | DigiKey (https://www.digikey.com/product-detail/en/on-semiconductor/PACDN042Y3R/PACDN042Y3ROSCT-ND/3487662) | Any sort of dual diode package that clamps a little bit higher than 5V
D2, | SOD-323 | 1 | $0.12 | $0.12 | 5.1V | On Semiconductor | MM3Z5V1ST1G | DigiKey (https://www.digikey.com/product-detail/en/on-semiconductor/MM3Z5V1ST1G/MM3Z5V1ST1GOSCT-ND/964547) | <Vgs of balance FETS (4.2-6.2V); 300mW
D3, | SOT-23-3 | 1 | $0.38 | $0.38 | SESDONCAN1LT1G | On Semiconductor | SESDONCAN1LT1G | DigiKey (https://www.digikey.com/product-detail/en/on-semiconductor/MM3Z5V1ST1G/MM3Z5V1ST1GOSCT-ND/964547) | Any Bidirectional CAN ESD supressor that can protect the CAN transceiver
D5, D4, | 0603 | 2 | $0.14 | $0.28 | RED | Wurth Electronics | 150060RS75000 | DigiKey (https://www.digikey.com/product-detail/en/wurth-electronics-inc/150060RS75000/732-4978-1-ND/4489899) | Vf ~2V
J3, | 0.1" Header | 1 | $0.00 | $0.00 | Conn_01x05 | Generic | NA | - | Any sort of 0.1" header for prototyping
J4, J9, | 0.1" Header | 2 | $0.00 | $0.00 | Conn_01x04 | Generic | NA | - | Any sort of 0.1" header for prototyping
J5, J6, J1, | 0.1" Header | 3 | $0.00 | $0.00 | Conn_01x03 | Generic | NA | - | Any sort of 0.1" header for prototyping
J7, | 0.1" Header | 1 | $0.00 | $0.00 | AVR-ISP-6 | Generic | NA | - | Any sort of 0.1" header for prototyping
J8, J2, | 0.1" Header | 2 | $0.00 | $0.00 | Conn_01x02 | Generic | NA | - | Any sort of 0.1" header for prototyping
R2, | 0603 | 1 | $0.01 | $0.01 | 1K | Yageo | RC0603FR-071KL | DigiKey (https://www.digikey.com/product-detail/en/yageo/RC0603FR-071KL/311-1.00KHRCT-ND/729790) | 1% tolerance or better
R5, R6, R1, R12, | 0603 | 4 | $0.01 | $0.04 | 100R | Yageo | RC0603FR-07100RL | DigiKey (https://www.digikey.com/product-detail/en/yageo/RC0603FR-07100RL/311-100HRCT-ND/729835) | 1% tolerance or better
R7, | 0603 | 1 | $0.01 | $0.01 | 240K | Yageo | RC0603FR-07240KL | DigiKey (https://www.digikey.com/product-detail/en/yageo/RC0603FR-07240KL/311-240KHRCT-ND/730029) | 1% tolerance or better
R8, R10, R4, R3, | 0603 | 4 | $0.01 | $0.04 | 10K | Yageo | RC0603FR-0710KL | DigiKey (https://www.digikey.com/product-detail/en/yageo/RC0603FR-0710KL/311-10.0KHRCT-ND/729827) | 1% tolerance or better
R9, | 0603 | 1 | $0.02 | $0.02 | 36R | Yageo | RC0603FR-0736RL | DigiKey (https://www.digikey.com/product-detail/en/yageo/RC0603FR-0736RL/311-36.0HRCT-ND/730125) | 1% tolerance or better
R11, | 0603 | 1 | $0.01 | $0.01 | 390R | Yageo | RC0603FR-07390RL | DigiKey (https://www.digikey.com/product-detail/en/yageo/RC0603FR-07390RL/311-390HRCT-ND/730145) | 1% tolerance or better
U1, | SOIC-8_W | 1 | $0.49 | $0.49 | W25Q16JVSSIQ | Winbond Electronics | W25Q16JVSSIQ | DigiKey (https://www.digikey.com/product-detail/en/winbond-electronics/W25Q16JVSSIQ/W25Q16JVSSIQ-ND/6193769) | 16MBit, Same pinout, Same functionality, ~8MHz SPI Capable
U2, | SOIC-8 | 1 | $0.55 | $0.55 | ATA6561 | Microchip Technology | ATA6561-GAQW-N | DigiKey (https://www.digikey.com/product-detail/en/microchip-technology/ATA6561-GAQW-N/ATA6561-GAQW-NCT-ND/9453180) | Same pinout, same functionality (e.g. TCAN1042VDRQ1) (https://www.digikey.com/product-detail/en/texas-instruments/TCAN1042VDRQ1/296-46214-1-ND/7033389)
U3, | SOIC-14 | 1 | $0.70 | $0.70 | ATtiny24 | Microchip Technology | ATTiny24A-SSU | DigiKey (https://www.digikey.com/product-detail/en/microchip-technology/ATTINY24A-SSU/ATTINY24A-SSU-ND/2050982) | Any part from the ATTinyX4 series with the same package
 |  | Total Cost |  | $3.29

Sheet: Regulator SubBoard 0-2
Reference Number | Package | Quantity | Price @Break | Total Price | Value | Manufacturer | Part Number | Supplier and Ref | Notes for Substitution
C2, C1, | 0805 | 2 | $0.30 | $0.59 | 1u | TDK Corporation | C2012X7S2A105M125AE | DigiKey (https://www.digikey.com/product-detail/en/tdk-corporation/C2012X7S2A105M125AE/445-6804-1-ND/2616435) | >=75V, X7R+ Rating preferrable (X5R probably would work)
C3, C6, C8, | 0603 | 3 | $0.03 | $0.08 | 100n | Samsung Electro-Mechanics | CL10B104KB8NNNC | DigiKey (https://www.digikey.com/product-detail/en/samsung-electro-mechanics/CL10B104KB8NNNC/1276-1000-1-ND/3889086) | >50V, X7R+ Rating preferrable (X5R probably would work)
C4, C5, C7, | 0805 | 3 | $0.14 | $0.43 | 4u7 | MuRata Electronics | GRM21BR71C475KE51L | DigiKey (https://www.digikey.com/product-detail/en/murata-electronics/GRM21BR71C475KE51L/490-14466-1-ND/6606927) | >=10V abs min, X7R+ Rating preferrable (X5R probably would work)
D1, | SOD-123 | 1 | $0.35 | $0.35 | 80V | MicroCommercial Devices | MBR0580-TP | DigiKey (https://www.digikey.com/product-detail/en/micro-commercial-co/MBR0580-TP/MBR0580-TPMSCT-ND/2423306) | >50V reverse, forward current should be >500mA
D3, D2, | 0603 | 2 | $0.14 | $0.28 | RED | Wurth Electronics | 150060RS75000 | DigiKey (https://www.digikey.com/product-detail/en/wurth-electronics-inc/150060RS75000/732-4978-1-ND/4489899) | Vf ~2V
D4, | SOD-323 | 1 | $0.10 | $0.10 | 100V 200mA | On Semiconductor | BAS16HT3G | DigiKey (https://www.digikey.com/product-detail/en/on-semiconductor/BAS16HT3G/BAS16HT3GOSCT-ND/9086375) | Pretty much anything; just for regulator protection *Note this won't fit the footprint on the board
J1, | 0.1" Header | 1 |  | $0.00 | NA | Generic | NA | - | Any sort of 0.1" header for prototyping
J2, | 0.1" Header | 1 |  | $0.00 | NA | Generic | NA | - | Any sort of 0.1" header for prototyping
L1, | Nonstandard | 1 | $0.45 | $0.45 | 47uH | Taiyo Yuden | NR4018T470M | DigiKey (https://www.digikey.com/product-detail/en/taiyo-yuden/NR4018T470M/587-1670-1-ND/1008285) | Any sort of 47uH inductor with >500mA current rating (check calculator for confirmation)
R2, R5, | 0603 | 2 | $0.01 | $0.02 | 10K | Yageo | RC0603FR-0710KL | DigiKey (https://www.digikey.com/product-detail/en/yageo/RC0603FR-0710KL/311-10.0KHRCT-ND/729827) | 1% tolerance or better
R3, | 0603 | 1 | $0.01 | $0.01 | 33K | Yageo | RC0603FR-0733KL | DigiKey (https://www.digikey.com/product-detail/en/yageo/RC0603FR-0733KL/311-33.0KHRCT-ND/730106) | 1% tolerance or better
R1, R4 | 0603 | 1 | $0.01 | $0.01 | 1K | Yageo | RC0603FR-071KL | DigiKey (https://www.digikey.com/product-detail/en/yageo/RC0603FR-071KL/311-1.00KHRCT-ND/729790) | 1% tolerance or better
R6, | 0603 | 1 | $0.01 | $0.01 | 390R | Yageo | RC0603FR-07390RL | DigiKey (https://www.digikey.com/product-detail/en/yageo/RC0603FR-07390RL/311-390HRCT-ND/730145) | 1% tolerance or better
R7, | 0603 | 1 | $0.01 | $0.01 | 100R | Yageo | RC0603FR-07100RL | DigiKey (https://www.digikey.com/product-detail/en/yageo/RC0603FR-07100RL/311-100HRCT-ND/729835) | 1% tolerance or better
U1, | SOT-23-6 | 1 | $2.88 | $2.88 | LMR16006 | Texas Instruments | LMR16006XDDCR | DigiKey (https://www.digikey.com/product-detail/en/texas-instruments/LMR16006XDDCR/296-40293-1-ND/5178170) | Any X variant; Y variant may be used, but component values would need to be recalculated
U2, | TO-252-2 | 1 | $0.59 | $0.59 | LD-1117 | Diodes Inc. | ZLDO1117K33TC | DigiKey (https://www.digikey.com/product-detail/en/diodes-incorporated/ZLDO1117K33TC/ZLDO1117K33DICT-ND/2095619) | Any regulator that has <1.7V dropout and is stable with low-value ceramic caps
 |  | Total Cost |  | $5.81

Sheet: Charger SubBoard 0-2
Reference Number | Package | Quantity | Price @Break | Total Price | Value | Manufacturer | Part Number | Supplier and Ref | Notes for Substitution
C3, | 1206 | 1 | $0.21 | $0.21 | 10u | Samsung Electro-Mechanics | CL31A106MBHNNNE | DigiKey (https://www.digikey.com/product-detail/en/samsung-electro-mechanics/CL31A106MBHNNNE/1276-6736-1-ND/5961595) | 35V absolute minimum, >=50V preferrable; X7R+ Rating preferrable (X5R possible?)
C4, C2, C1, | 0603 | 3 | $0.03 | $0.08 | 100n | Samsung Electro-Mechanics | CL10B104KB8NNNC | DigiKey (https://www.digikey.com/product-detail/en/samsung-electro-mechanics/CL10B104KB8NNNC/1276-1000-1-ND/3889086) | >50V, X7R+ Rating preferrable (X5R probably would work)
C6, | 0805 | 1 | $0.14 | $0.14 | 4u7 | MuRata Electronics | GRM21BR71C475KE51L | DigiKey (https://www.digikey.com/product-detail/en/murata-electronics/GRM21BR71C475KE51L/490-14466-1-ND/6606927) | >=10V abs min, X7R+ Rating preferrable (X5R probably would work)
C7, | CP_Radial_D10.0mm_P5.00mm | 1 | $2.97 | $2.97 | 47u | Nichicon | PLV1J470MDL1 | DigiKey (https://www.digikey.com/product-detail/en/nichicon/PLV1J470MDL1/493-14185-ND/4991366) | 40uF+, 63V+, 2.125A+ Ripple Rating, <= 73mOhm ESR
C8, C5, | 0805 | 2 | $0.30 | $0.59 | 1u | TDK Corporation | C2012X7S2A105M125AE | DigiKey (https://www.digikey.com/product-detail/en/tdk-corporation/C2012X7S2A105M125AE/445-6804-1-ND/2616435) | >=75V, X7R+ Rating preferrable (X5R probably would work)
C9, C10, C11, | 0603 | 3 | $0.05 | $0.14 | 10n | Samsung Electro-Mechanics | CL10B103KC8NNNC | DigiKey (https://www.digikey.com/product-detail/en/samsung-electro-mechanics/CL10B103KC8NNNC/1276-1196-1-ND/3889282) | >=75V, X7R+ Rating preferrable (X5R probably would work)
D1, D3, | SOD-323 | 2 | $0.16 | $0.32 | 12V | Nexperia | PDZ12BGWJ | DigiKey (https://www.digikey.com/product-detail/en/nexperia-usa-inc/PDZ12BGWJ/1727-7763-1-ND/8640744) | 10-15V (less than Vgs_max of FETs), 365mW or better power rating
D2, | SMA | 1 | $0.39 | $0.39 | 5A >50V | Vishay Semiconductor | VSSAF510-M3/H | DigiKey (https://www.digikey.com/product-detail/en/vishay-semiconductor-diodes-division/VSSAF510-M3-H/VSSAF510-M3-HGICT-ND/9601403) | 5A If, 50V Vr, Shottky, Low Vf Preferrable
J2, J4, J1, J5, | 0.1" Header | 4 | $0.00 | $0.00 | Conn_01x02 | Generic | NA | - | Any sort of 0.1" header for prototyping
J3, | 0.1" Header | 1 | $0.00 | $0.00 | Conn_01x04 | Generic | NA | - | Any sort of 0.1" header for prototyping
L1, | Nonstandard | 1 | $1.04 | $1.04 | 22uH | Sumida | 104CDMCCDS-220MC | DigiKey (https://www.digikey.com/product-detail/en/sumida-america-components-inc/104CDMCCDS-220MC/308-2498-1-ND/9490545) | 22uH, >=5A saturation and operating current rating
Q1, Q4, | SOT-23-3 | 2 | $0.17 | $0.33 | RUC002N05HZGT116 | Rohm Semiconductor | RUC002N05HZGT116 | DigiKey (https://www.digikey.com/product-detail/en/rohm-semiconductor/RUC002N05HZGT116/RUC002N05HZGT116CT-ND/8026658) | >=50Vds min, defined Rds_on at 1.5V gate drive, 120mA Id with Ta = 45C
Q2, Q5, | Vishay_PowerPAK_1212-8_Single | 2 | $1.10 | $2.20 | SQJ479EP | Vishay Siliconix | SQJ479EP-T1_GE3 | DigiKey (https://www.digikey.com/product-detail/en/vishay-siliconix/SQJ479EP-T1_GE3/SQJ479EP-T1_GE3CT-ND/6708994) | >=60Vds min, <50mOhm RdsOn
Q3, | TO252-2 | 1 | $1.33 | $1.33 | TK7S10N1Z | Toshiba Semiconductor | TK7S10N1Z,LQ | DigiKey (https://www.digikey.com/product-detail/en/toshiba-semiconductor-and-storage/TK7S10N1ZLQ/TK7S10N1ZLQCT-ND/4815244) | Switch FET, Low Qg, >=60Vds, run through calculator to make sure
R2, R19, | 0603 | 2 | $0.01 | $0.02 | 240K | Yageo | RC0603FR-07240KL | DigiKey (https://www.digikey.com/product-detail/en/yageo/RC0603FR-07240KL/311-240KHRCT-ND/730029) | 1% tolerance or better
R6, R4, | 2512 | 2 | $0.30 | $0.60 | 200R 1W | Stackpole Electronics | RMCF2512JT200R | DigiKey (https://www.digikey.com/product-detail/en/stackpole-electronics-inc/RMCF2512JT200R/RMCF2512JT200RCT-ND/2419087) | >=1W
R7, | 0603 | 1 | $0.01 | $0.01 | 390R | Yageo | RC0603FR-07390RL | DigiKey (https://www.digikey.com/product-detail/en/yageo/RC0603FR-07390RL/311-390HRCT-ND/730145) | 1% tolerance or better
R9, R12, | 2512 | 2 | $0.74 | $1.48 | 20mR 3/4W | Yageo | PE2512FKE7W0R02L | DigiKey (https://www.digikey.com/product-detail/en/yageo/PE2512FKE7W0R02L/YAG2170CT-ND/5139618) | >=0.75W, 1%, <75ppm/C temp co ideally
R15, R14, R11, R10, R3, R21, | 0603 | 6 | $0.01 | $0.06 | 10K | Yageo | RC0603FR-0710KL | DigiKey (https://www.digikey.com/product-detail/en/yageo/RC0603FR-0710KL/311-10.0KHRCT-ND/729827) | 1% tolerance or better
R16, R17, R13, | 0603 | 3 | $0.01 | $0.03 | 33K | Yageo | RC0603FR-0733KL | DigiKey (https://www.digikey.com/product-detail/en/yageo/RC0603FR-0733KL/311-33.0KHRCT-ND/730106) | 1% tolerance or better
R18, R5, R8, R1, R20, | 0603 | 5 | $0.01 | $0.05 | 1K | Yageo | RC0603FR-071KL | DigiKey (https://www.digikey.com/product-detail/en/yageo/RC0603FR-071KL/311-1.00KHRCT-ND/729790) | 1% tolerance or better
U1, | SOT-23-5 | 1 | $0.59 | $0.59 | INA180B | Texas Instruments | INA180A1IDBVT | DigiKey (https://www.digikey.com/product-detail/en/texas-instruments/INA180A1IDBVT/296-46627-1-ND/7219063) | Same pinout, 20-25V/V, 20V+ input
U2, | TSSOP-16-EP | 1 | $6.91 | $6.91 | LTC3783 | Linear Technology | LTC3783EFE#PBF | DigiKey (https://www.digikey.com/product-detail/en/linear-technology-analog-devices/LTC3783EFE-PBF/LTC3783EFE-PBF-ND/1620122) | -
 |  | Total Cost |  | $19.49

Sheet: Power Stage SubBoard 0-2
Reference Number | Package | Quantity | Price @Break | Total Price | Value | Manufacturer | Part Number | Supplier and Ref | Notes for Substitution
C3, C1, C16, C17, C11, C12, C9, C10, C14, C15, C2, | 0603 | 11 | $0.03 | $0.31 | 100n | Samsung Electro-Mechanics | CL31A106MBHNNNE | DigiKey (https://www.digikey.com/product-detail/en/samsung-electro-mechanics/CL31A106MBHNNNE/1276-6736-1-ND/5961595) | 35V absolute minimum, >=50V preferrable; X7R+ Rating preferrable (X5R possible?)
C4, C13, | 0603 | 2 | $0.05 | $0.09 | 10n | Samsung Electro-Mechanics | CL10B103KC8NNNC | DigiKey (https://www.digikey.com/product-detail/en/samsung-electro-mechanics/CL10B103KC8NNNC/1276-1196-1-ND/3889282) | >=75V, X7R+ Rating preferrable (X5R probably would work)
C5, C6, C8, | 0805 | 3 | $0.30 | $0.89 | 1u | TDK Corporation | C2012X7S2A105M125AE | DigiKey (https://www.digikey.com/product-detail/en/tdk-corporation/C2012X7S2A105M125AE/445-6804-1-ND/2616435) | >=75V, X7R+ Rating preferrable (X5R probably would work)
C7, | 1206 | 1 | $0.21 | $0.21 | 10u | Samsung Electro-Mechanics | CL31A106MBHNNNE | DigiKey (https://www.digikey.com/product-detail/en/samsung-electro-mechanics/CL31A106MBHNNNE/1276-6736-1-ND/5961595) | 35V absolute minimum, >=50V preferrable; X7R+ Rating preferrable (X5R possible?)
D3, D2, D1, | SOD-323 | 3 | $0.16 | $0.47 | 12V | Nexperia | PDZ12BGWJ | DigiKey (https://www.digikey.com/product-detail/en/nexperia-usa-inc/PDZ12BGWJ/1727-7763-1-ND/8640744) | 10-15V (less than Vgs_max of FETs), 365mW or better power rating
D4, | SMC | 1 | $0.56 | $0.56 | 58V TVS | SMC Diode Solutions | 3.0SMI58ATR | DigiKey (https://www.digikey.com/product-detail/en/smc-diode-solutions/3.0SMI58ATR/1655-2077-1-ND/9566395) | So I'm not 100% sure, Vr 55~60V, >=1.8kW Peak Power Pulse (look at TI application circuit for BQ76930 for an idea)
D5, | 0603 | 1 | $0.14 | $0.14 | RED | Wurth Electronics | 150060RS75000 | DigiKey (https://www.digikey.com/product-detail/en/wurth-electronics-inc/150060RS75000/732-4978-1-ND/4489899) | Vf ~2V
F1, | Fuse_1025HCxx-RTR | 1 | $4.78 | $4.78 | 40A | Littelfuse | 0456040.DR | DigiKey (https://www.digikey.com/product-detail/en/littelfuse-inc/0456040.DR/F3364CT-ND/2080265) | Something like this (https://www.digikey.com/product-detail/en/eaton-electronics-division/1025HC40-RTR/283-4681-1-ND/6187865)
FB5, FB4, FB3, FB2, FB1, | 0603 | 5 | $0.17 | $0.85 | 600R | Wurth Electronics | 742792651 | DigiKey (https://www.digikey.com/product-detail/en/wurth-electronics-inc/742792651/732-1593-1-ND/1639537) | 100mA DC capable; approximately 600 Ohm @100MHz (not super critical)
J2, J1, J5, J6, | 0.1" Header | 4 | $0.00 | $0.00 | Conn_01x02 | Generic | NA | - | Any sort of 0.1" header for prototyping
J3, | 0.1" Header | 1 | $0.00 | $0.00 | Conn_01x04 | Generic | NA | - | Any sort of 0.1" header for prototyping
J4, | 0.1" Header | 1 | $0.00 | $0.00 | Conn_01x07 | Generic | NA | - | Any sort of 0.1" header for prototyping
Q1, | TO-252-2 | 1 | $1.33 | $1.33 | TK7S10N1Z | Toshiba Semiconductor | TK7S10N1Z,LQ | DigiKey (https://www.digikey.com/product-detail/en/toshiba-semiconductor-and-storage/TK7S10N1ZLQ/TK7S10N1ZLQCT-ND/4815244) | Switch FET, Low Qg, >=60Vds, run through calculator to make sure
Q2, | Vishay_PowerPAK_1212-8_Single | 1 | $1.10 | $1.10 | SQJ479EP | Vishay Siliconix | SQJ479EP-T1_GE3 | DigiKey (https://www.digikey.com/product-detail/en/vishay-siliconix/SQJ479EP-T1_GE3/SQJ479EP-T1_GE3CT-ND/6708994) | >=60Vds min, <50mOhm RdsOn
Q4, Q3, Q5, | TO-252-2 | 3 | $1.57 | $4.71 | FDD86367 | On Semiconductor | FDD86367-F085 | DigiKey (https://www.digikey.com/product-detail/en/on-semiconductor/FDD86367-F085/FDD86367-F085CT-ND/5289188) | >=60Vds min, <~6mOhom or better RdsOn
Q6, | SOT-23 | 1 | $0.17 | $0.17 | RUC002N05HZGT116 | Rohm Semiconductor | RUC002N05HZGT116 | DigiKey (https://www.digikey.com/product-detail/en/rohm-semiconductor/RUC002N05HZGT116/RUC002N05HZGT116CT-ND/8026658) | >=50Vds min, defined Rds_on at 1.5V gate drive, 120mA Id with Ta = 45C
R3, | 2512 | 1 | $0.71 | $0.71 | 1mR | Riedon | CSR2512C0R001F | DigiKey (https://www.digikey.com/product-detail/en/riedon/CSR2512C0R001F/696-1185-1-ND/2813309) | >2W, 3W preferrable at least, 75ppm/C or better
R7, R11, | 0603 | 2 | $0.01 | $0.02 | 240K | Yageo | RC0603FR-07240KL | DigiKey (https://www.digikey.com/product-detail/en/yageo/RC0603FR-07240KL/311-240KHRCT-ND/730029) | 1% tolerance or better
R8, R20, | 0603 | 2 | $0.01 | $0.02 | 10K | Yageo | RC0603FR-0710KL | DigiKey (https://www.digikey.com/product-detail/en/yageo/RC0603FR-0710KL/311-10.0KHRCT-ND/729827) | 1% tolerance or better
R12, R10, R6, R18, R4, R2, R1, R19, | 0603 | 8 | $0.01 | $0.08 | 100R | Yageo | RC0603FR-07100RL | DigiKey (https://www.digikey.com/product-detail/en/yageo/RC0603FR-07100RL/311-100HRCT-ND/729835) | 1% tolerance or better
R13, R9, R5, | 0603 | 3 | $0.01 | $0.03 | 10M | Yageo | RC0603FR-0710ML | DigiKey (https://www.digikey.com/product-detail/en/yageo/RC0603FR-0710ML/311-10.0MHRCT-ND/729828) | 5% tolerance or better
R14, R15, R16, R17, | 2512 | 4 | $0.30 | $1.20 | 200R 1W | Stackpole Electronics | RMCF2512JT200R | DigiKey (https://www.digikey.com/product-detail/en/stackpole-electronics-inc/RMCF2512JT200R/RMCF2512JT200RCT-ND/2419087) | >=1W
U1, | SOT-23-6 | 1 | $2.24 | $2.24 | MCP3425A0T-ECH | Microchip Technology | MCP3425A0T-ECH | DigiKey (https://www.digikey.com/product-detail/en/microchip-technology/MCP3425A0T-E-CH/MCP3425A0T-E-CHCT-ND/1979810) | Some sort of 12+ Bit I2C Differential ADC; PGA is nice
U2, | SOT-23-6 | 1 | $1.70 | $1.70 | MCP6C02_xxx | Microchip Technology | MCP6C02T-050E/CHY | DigiKey (https://www.digikey.com/product-detail/en/microchip-technology/MCP6C02T-050E-CHY/MCP6C02T-050E-CHYCT-ND/9757867) | Any part in the family *should* work
U3, | TSSOP-16 | 1 | $2.41 | $2.41 | BQ76200 | Texas Instruments | BQ76200PWR | DigiKey (https://www.digikey.com/product-detail/en/texas-instruments/BQ76200PWR/296-43273-1-ND/5801511) | -
 |  | Total Cost |  | $24.02
