Govish/FusIon-Pack/Documentation/LV Buck Converter Calcs.xlsx

LV Buck Converter Calculations |  |  |  |  |  |  |  | Approximate Cost:
Converter Params: | Vin (max) | Vin (min) | Vout | Iout | Max Load Step | Vripple | Fsw (MHz) |  | $5.15
 | 42 | 30 | 5.022884972 | 0.4 | 0.3 | 0.1 | 0.7
IC Selection
 | For LMR16006X | Datasheet (http://www.ti.com/lit/ds/symlink/lmr16006.pdf) |  |  |  | TI LM16006DDCR (https://www.digikey.com/product-detail/en/texas-instruments/LMR16006XDDCR/296-40293-1-ND/5178170) | x | Cost: | $2.88
Inductor Selection
Device Params: | Inductance (uH) | ESR | Estimated Irms |  | Req'd current rating (A) | K-factor (0.2 < x < 0.4)
 | 47 | 0.78 | 0.402 |  | 0.4707964408 | 0.3539822042
Comp. Vout | 5.336444972 |  |  |  |  | Taiyo Yuden NR4018T470M (https://www.digikey.com/product-detail/en/taiyo-yuden/NR4018T470M/587-1670-1-ND/1008285) | x | Cost: | $0.45
Iripple | 0.1415928817
K-factor | 0.3539822042
Irms | 0.4020829666
Ilpeak | 0.4707964408
Output Capacitor Selection
Device Params: | Quantity | Capacitance (uF) |  |  |  | In BOM | x | Cost: | $0.26
 | 2 | 4.7
 | Min req'd Capacitance (uF)
C_load_step | 8.571428571
C_load_drop | 0.354364865
Ripple spec | 0.2528444316
Ceramic Cap ESR Insignificant, so calc ignored
Diode Selection
Device Params: | V_reverse | If
 | 52.5 | 0.4 |  |  |  | Diodes Inc. MBR0580S1-7 (https://www.digikey.com/product-detail/en/diodes-incorporated/MBR0580S1-7/MBR0580S1-7DICT-ND/5080371) | x | Cost: | $0.28
Input Capacitor Selection
Device Params: | Capacitance (uF):
 | 1.1 | <- Accounting for DC Bias (actually 2x 1u + 100n) |  |  |  | In BOM | x | Cost: | $1.06
Irms | 0.1529651837
Vin_ripple (mV) | 129.8701299 | (<0.5%)
Bootstrap Capacitor
Device Params: | Capacitance
 | 100n |  |  |  |  | In BOM | x | Cost: | $0.06
Feedback Resistors
Device Params: | Top R_divider (kOhm) | R_bot (kOhm)
 | 30 | 5.39
 | 30k | 10k // 10k + 390R |  |  |  | In BOM | x | Cost: | $0.16
Vout | 5.022884972
