Govish/FusIon-Pack/Documentation/Component Profiles.JPG

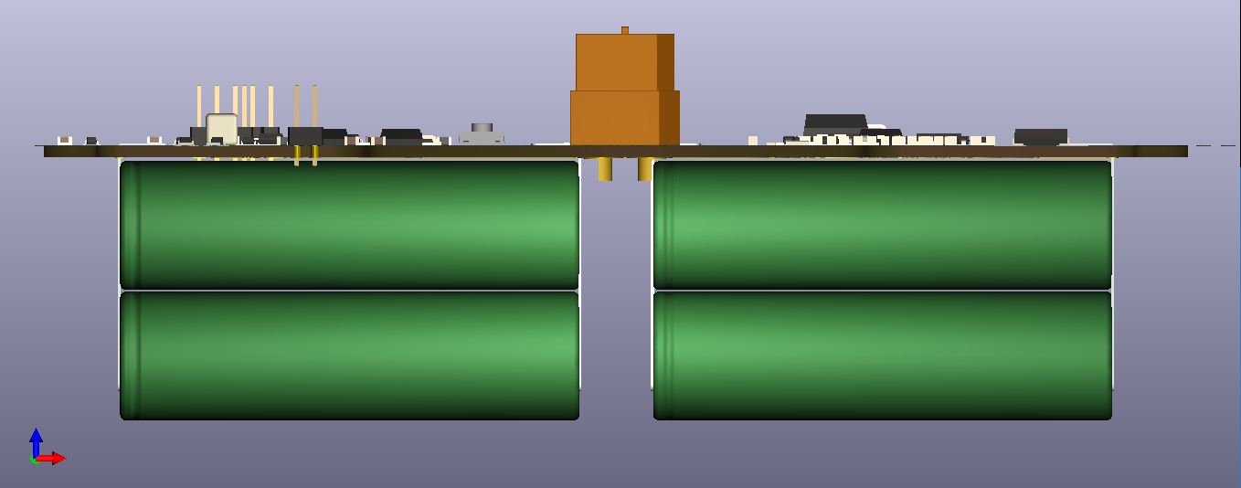
Documentation/Component Profiles.JPG
