Govish/FusIon-Pack/REV 0-1 PCB/Kicad Files/Fusion Dummy Mainboard Test Fit/Fusion Dummy Mainboard Test Fit.step

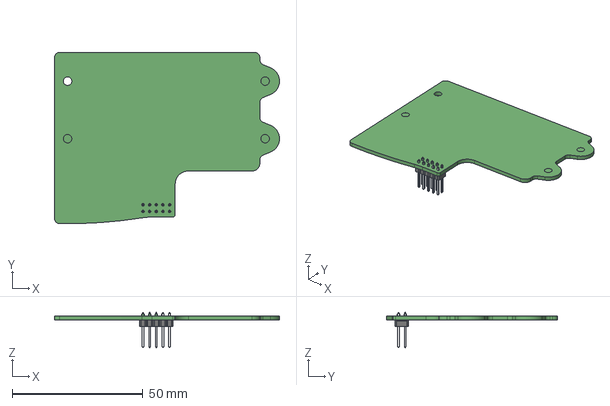
[picture p6: CAD file, 2019-04-24]
REV 0-1 PCB/Kicad Files/Fusion Dummy Mainboard Test Fit/Fusion Dummy Mainboard Test Fit.step
86.0 x 65.5 x 13.6 mm
