Govish/FusIon-Pack/Renderings/Renderings Case Top Up Print 4-28/rendering0.jpg

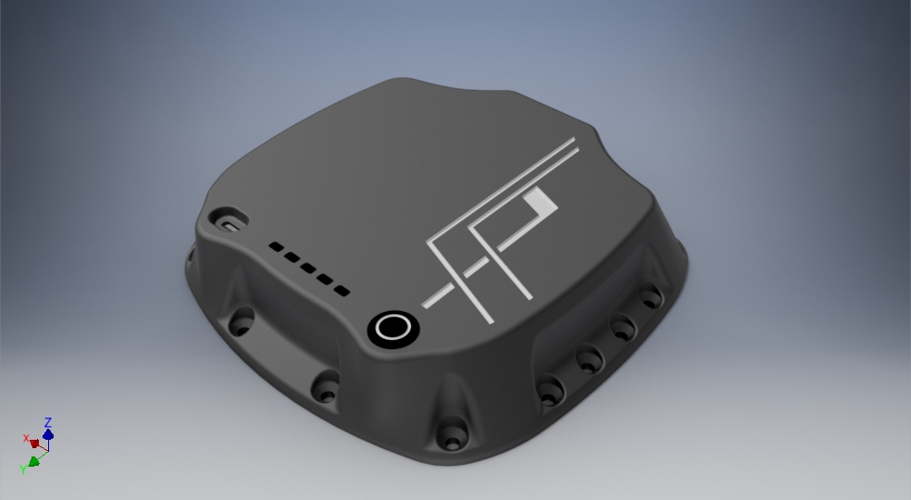
Renderings/Renderings Case Top Up Print 4-28/rendering0.jpg
