Govish/FusIon-Pack/Documentation/LV Buck Converter Rough Sim.pdf

## WEBENCH ® Design Report

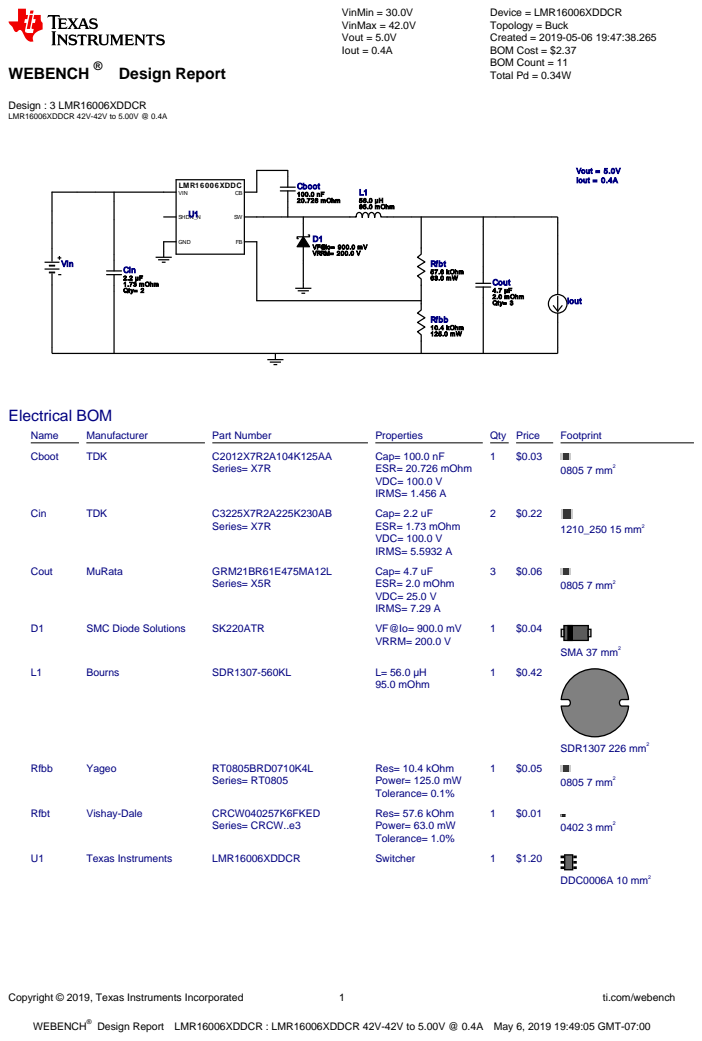
[picture p12: page 1]
Copyright © 2019, Texas Instruments Incorporated; ti.com/webench; WEBENCH®; Design : 3 LMR16006XDDCR LMR16006XDDCR 42V-42V to 5.00V @ 0.4A; VinMin = 30.0V VinMax = 42.0V Vout = 5.0V Iout = 0.4A; Device = LMR16006XDDCR Topology = Buck Created = 2019-05-06 19:47:38.265 BOM Cost = $2.37 BOM Count = 11 Total Pd = 0.34W; Cboot 100.0 nF 20.726 mOhm; Cout 4.7 µF 2.0 mOhm Qty= 3; L1 56.0 µH 95.0 mOhm; Rfbt 57.6 kOhm 63.0 mW; Vout = 5.0V Iout = 0.4A; Cin 2.2 µF 1.73 mOhm Qty= 2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

Design Report LMR16006XDDCR : LMR16006XDDCR 42V-42V to 5.00V @ 0.4A May 6, 2019 19:49:05 GMT-07:00

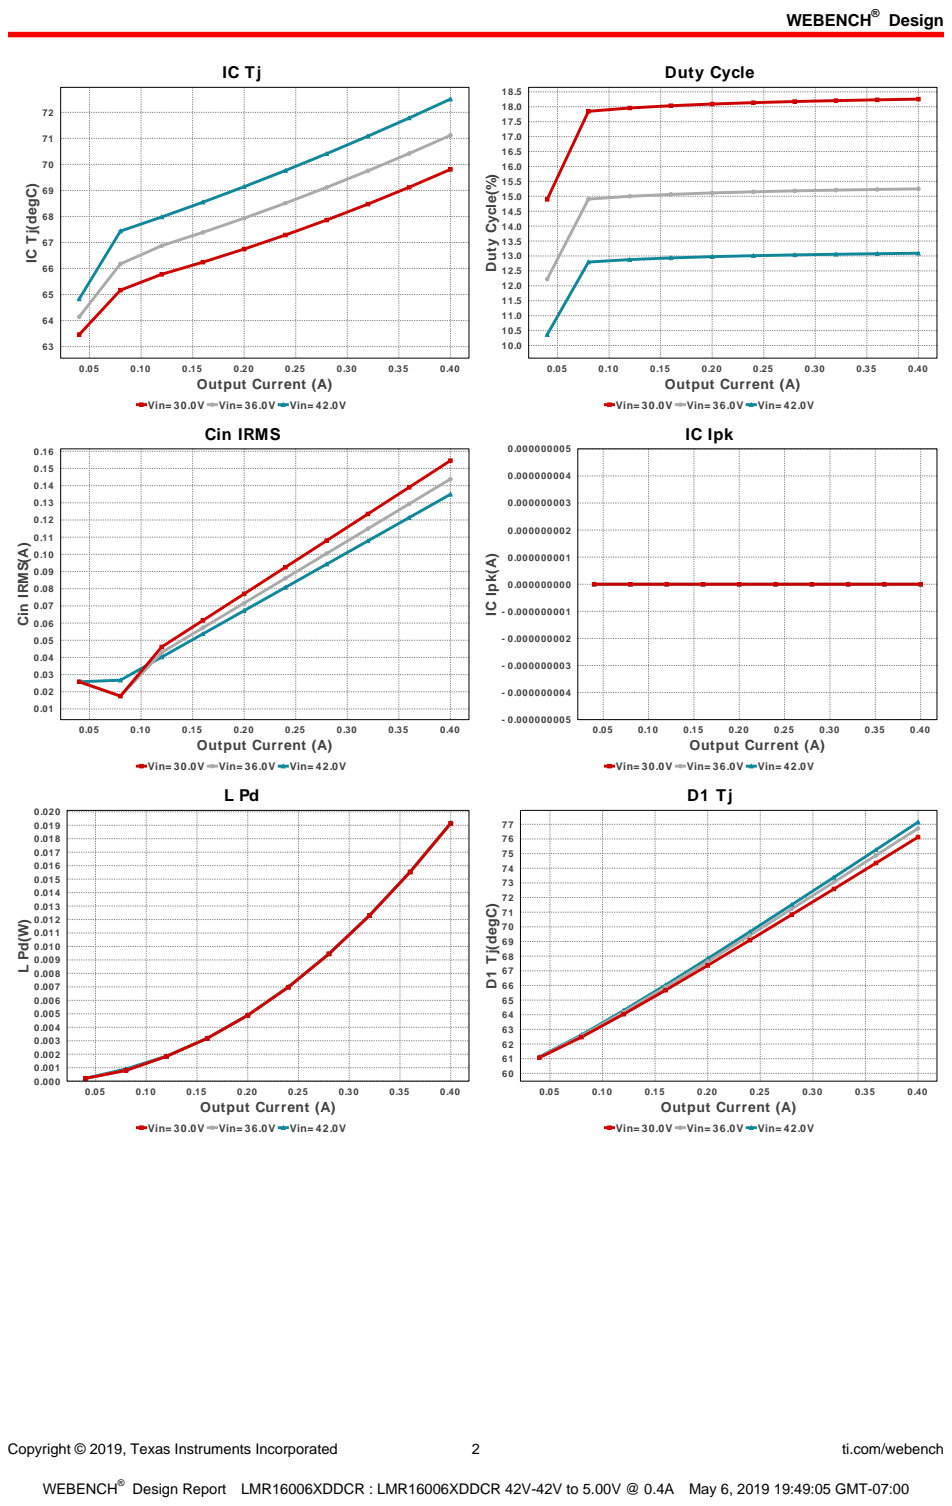
[picture p13: page 2]
Design; Copyright © 2019, Texas Instruments Incorporated; ti.com/webench; 0.40 Output Current (A); Duty Cycle; Duty Cycle(%); Cin IRMS(A); IC Ipk; IC Ipk(A); D1 Tj(degC)

IC Tj(degC)

Vin= 30.0V Vin= 36.0V Vin= 42.0V
Cin IRMS

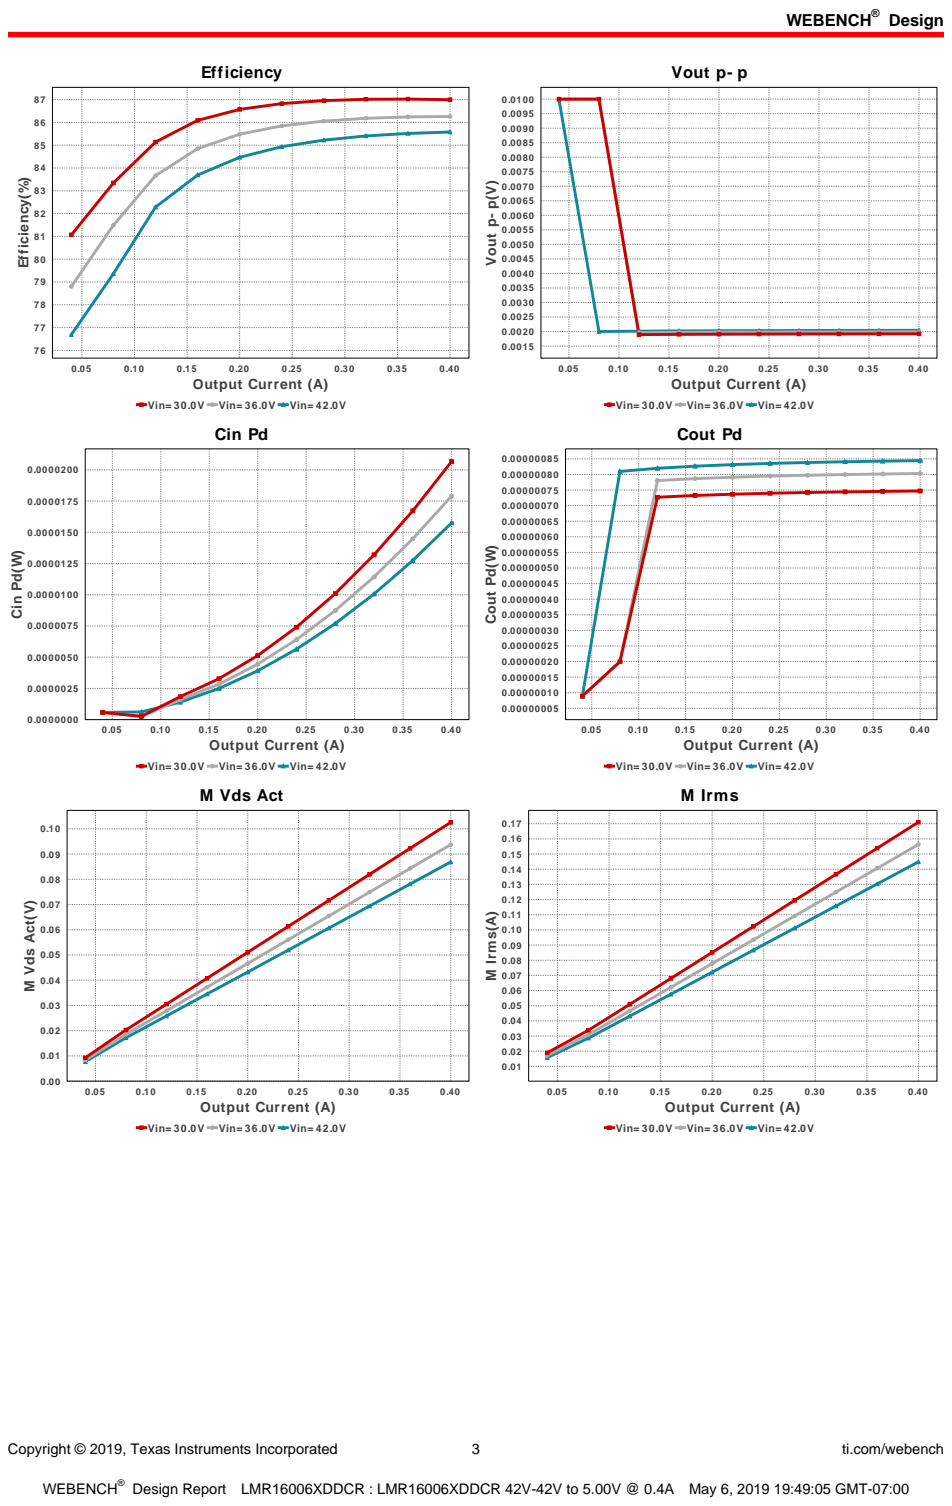
[picture p14: page 3]
Copyright © 2019, Texas Instruments Incorporated; ti.com/webench; Efficiency; 0.40 Output Current (A); Efficiency(%); Vout p- p; Vout p- p(V); Cin Pd; Cin Pd(W); Cout Pd; Cout Pd(W); M Vds Act(V); M Irms; M Irms(A)

Vin= 30.0V Vin= 36.0V Vin= 42.0V

M Vds Act

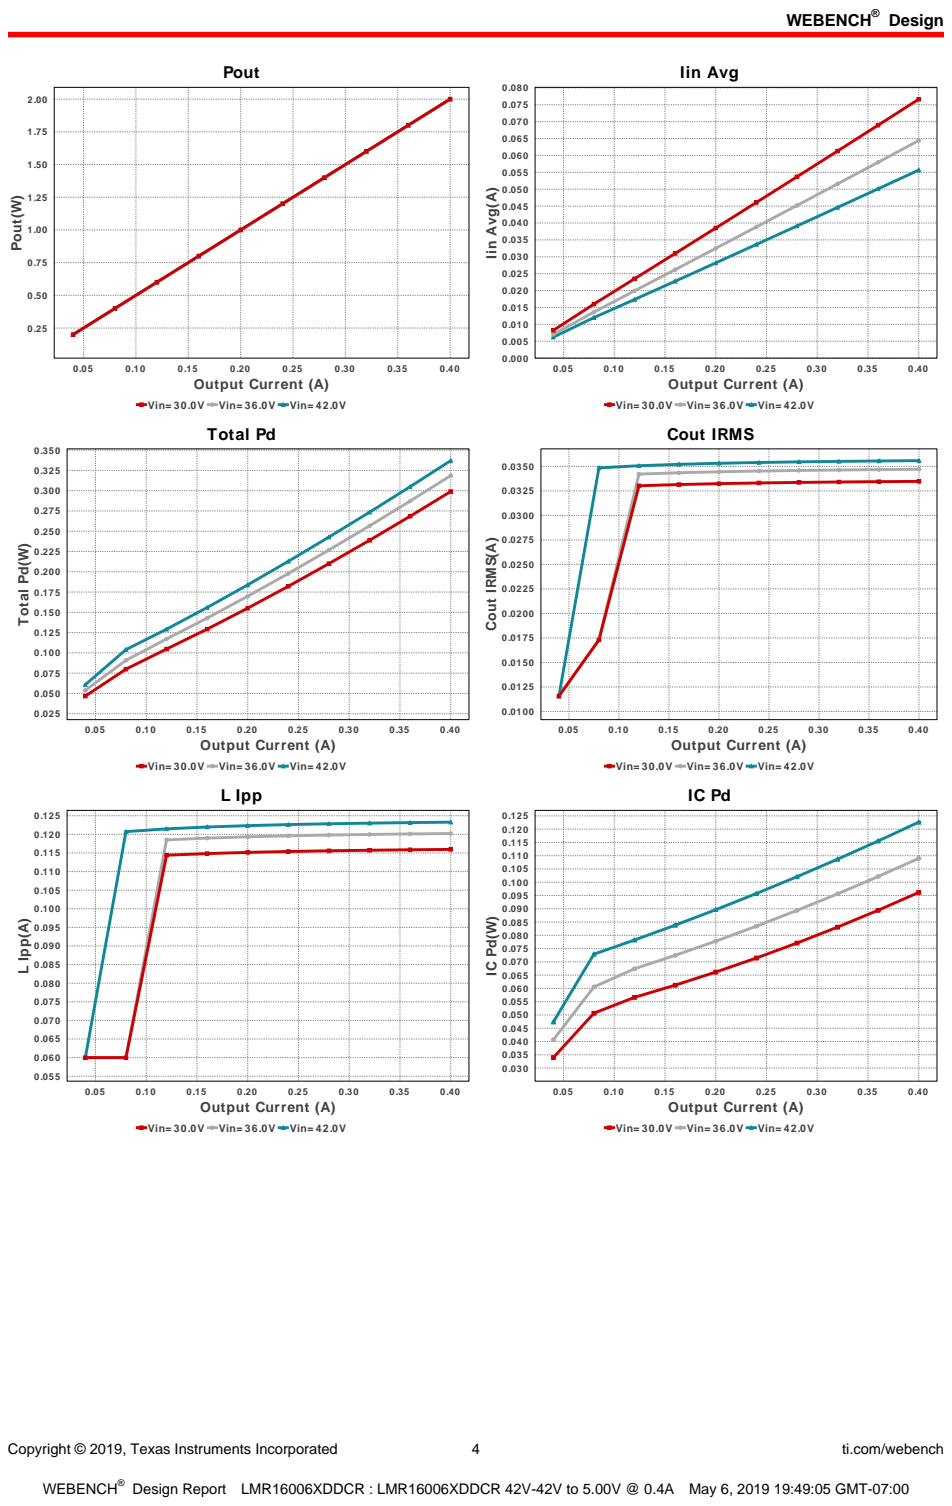
[picture p15: page 4]
Copyright © 2019, Texas Instruments Incorporated; ti.com/webench; Pout; 0.40 Output Current (A); Pout(W); Iin Avg; Iin Avg(A); Total Pd; Total Pd(W); Cout IRMS(A); L Ipp; L Ipp(A)

Vin= 30.0V Vin= 36.0V Vin= 42.0V

Cout IRMS

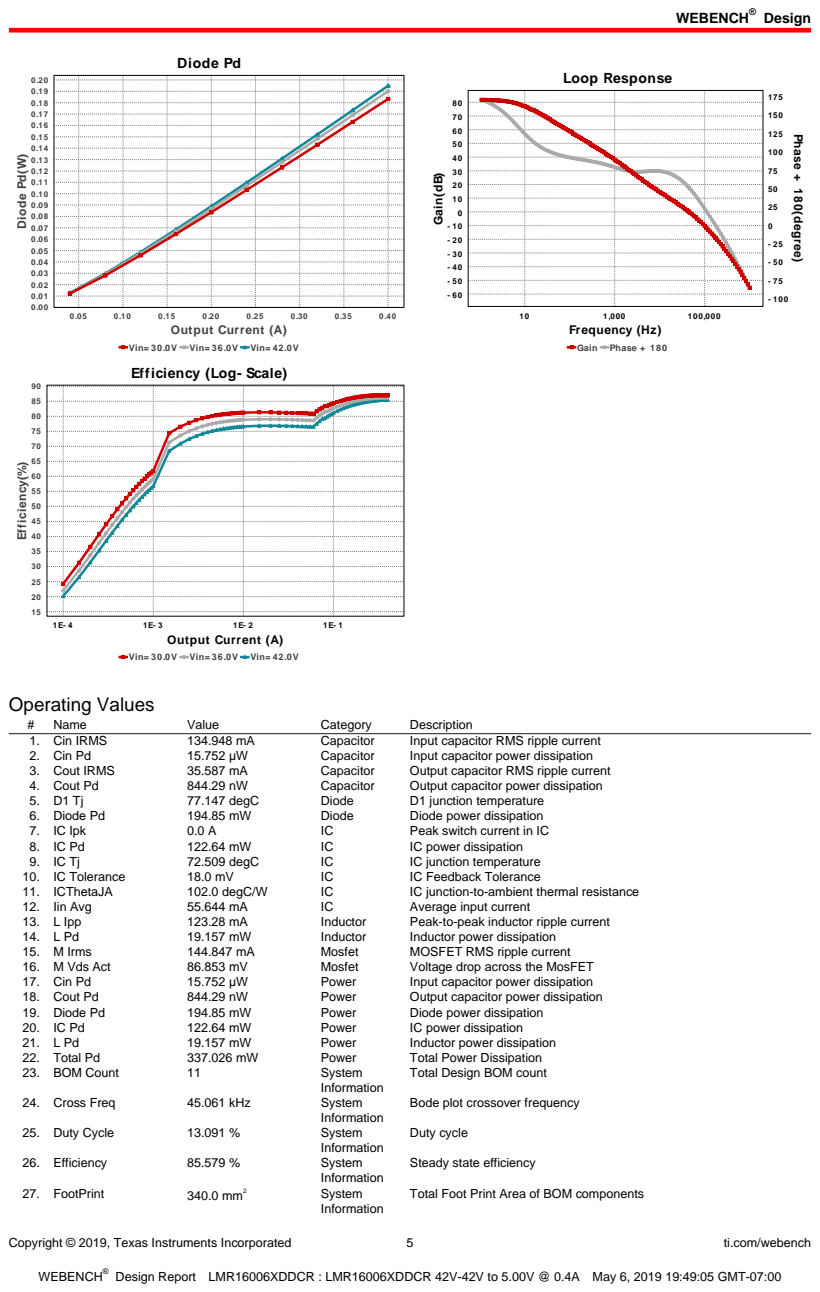
[picture p16: page 5]
Copyright © 2019, Texas Instruments Incorporated; ti.com/webench; Diode Pd; 0.40 Output Current (A); Diode Pd(W); Loop Response; Gain Phase + 180; 100,000 Frequency (Hz); Gain(dB); Phase + 180(degree); 1E- 1 Output Current (A); Efficiency(%); Operating Values; Name; Value; Category; Description; 1. Cin IRMS; Capacitor; Input capacitor RMS ripple current; 2. Cin Pd; Input capacitor power dissipation; 3. Cout IRMS; Output capacitor RMS ripple current; 4. Cout Pd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

Vin= 30.0V Vin= 36.0V Vin= 42.0V
Efficiency (Log- Scale)

Total Design BOM count

Bode plot crossover frequency

Steady state efficiency

Total Foot Print Area of BOM components

Copyright © 2019, Texas Instruments Incorporated | 6 | ti.com/webench
# | Name | Value | Category | Description

28. Frequency | 700.0 kHz | System
| | | Information | Switching frequency
29. Iout | 400.0 mA | System
| | | Information | Iout operating point
30. Mode | CCM | System
| | | Information | Conduction Mode
31. Phase Marg | 51.602 deg | System
| | | Information | Bode Plot Phase Margin
32. Pout | 2.0 W | System
| | | Information | Total output power
33. Total BOM | $2.37 | System
| | | Information | Total BOM Cost
34. Vin | 42.0 V | System
| | | Information | Vin operating point
35. Vout | 5.0 V | System
| | | Information | Operational Output Voltage
36. Vout Actual | 5.002 V | System
| | | Information | Vout Actual calculated based on selected voltage divider resistors
37. Vout Tolerance | 3.308 % | System
| | | Information | Vout Tolerance based on IC Tolerance (no load) and voltage divider resistors if applicable
38. Vout p-p | 2.043 mV | System
| | | Information | Peak-to-peak output ripple voltage

## Design Inputs

Name | Value | Description
| Iout | | 400.0 m | Maximum Output Current
VinMax | 42.0 | Maximum input voltage
VinMin | 30.0 | Minimum input voltage
Vout | 5.0 | Output Voltage
| base_pn | | LMR16006X | Base Product Number
source | DC | Input Source Type
Ta | 60.0 | Ambient temperature


Copyright © 2019, Texas Instruments Incorporated | 7 | ti.com/webench

## Assembly

## Component Testing

Some published data on components in datasheets such as Capacitor ESR and Inductor DC resistance is based on conservative values that will guarantee that the components always exceed the specification. For design purposes it is usually better to work with typical values. Since this data is not always available it is a good practice to measure the Capacitance and ESR values of Cin and Cout, and the inductance and DC resistance of L1 before assembly of the board. Any large discrepancies in values should be electrically simulated in WEBENCH to check for instabilities and thermally simulated in WebTHERM to make sure critical temperatures are not exceeded.

## Soldering Component to Board

If board assembly is done in house it is best to tack down one terminal of a component on the board then solder the other terminal. For surface mount parts with large tabs, such as the DPAK, the tab on the back of the package should be pre-tinned with solder, then tacked into place by one of the pins. To solder the tab town to the board place the iron down on the board while resting against the tab, heating both surfaces simultaneously. Apply light pressure to the top of the plastic case until the solder flows around the part and the part is flush with the PCB. If the solder is not flowing around the board you may need a higher wattage iron (generally 25W to 30W is enough).

## Initial Startup of Circuit

It is best to initially power up the board by setting the input supply voltage to the lowest operating input voltage 30.0V and set the input supply's current limit to zero. With the input supply off connect up the input supply to Vin and GND. Connect a digital volt meter and a load if needed to set the minimum Iout of the design from Vout and GND. Turn on the input supply and slowly turn up the current limit on the input supply.
If the voltage starts to rise on the input supply continue increasing the input supply current limit while watching the output voltage. If the current increases on the input supply, but the voltage remains near zero, then there may be a short or a component misplaced on the board. Power down the board and visually inspect for solder bridges and recheck the diode and capacitor polarities. Once the power supply circuit is operational then more extensive testing may include full load testing, transient load and line tests to compare with simulation results.

## Load Testing

The setup is the same as the initial startup, except that an additional digital voltmeter is connected between Vin and GND, a load is connected between Vout and GND and a current meter is connected in series between Vout and the load. The load must be able to handle at least rated output power + 50% ( 7.5 watts for this design). Ideally the load is supplied in the form of a variable load test unit. It can also be done in the form of suitably large power resistors. When using an oscilloscope to measure waveforms on the prototype board, the ground leads of the oscilloscope probes should be as short as possible and the area of the loop formed by the ground lead should be kept to a minimum. This will help reduce ground lead inductance and eliminate EMI noise that is not actually present in the circuit.

## Design Assistance

1. Master key : CEA4B19E92263706[v1]
2. LMR16006X Product Folder : http://www.ti.com/product/LMR16006 : contains the data sheet and other resources.

Copyright © 2019, Texas Instruments Incorporated | 8 | ti.com/webench

Important Notice and Disclaimer

TI provides technical and reliability data (including datasheets), design resources (including reference designs), application or other design advice, web tools, safety information, and other resources AS IS and with all faults, and disclaims all warranties. These resources are intended for skilled developers designing with TI products. You are solely responsible for (1) selecting the appropriate TI products for your application, (2) designing, validating and testing your application, and (3) ensuring your application meets applicable standards, and any other safety, security, or other requirements.

These resources are subject to change without notice. TI grants you permission to use these resources only for development of an application that uses the TI products described in the resource. Other reproduction and display of these resources is prohibited. No license is granted to any other TI intellectual property right or to any third party intellectual property right. TI disclaims responsibility for, and you will fully indemnify TI and its representatives against, any claims, damages, costs, losses, and liabilities arising out of your use of these resources.

Providing these resources does not expand or otherwise alter TI's applicable Terms of Sale or other applicable terms available either on ti.com or provided in conjunction with TI products.
