Govish/FusIon-Pack/REV 0-1 PCB/Kicad Files/FusIon Pack.pdf

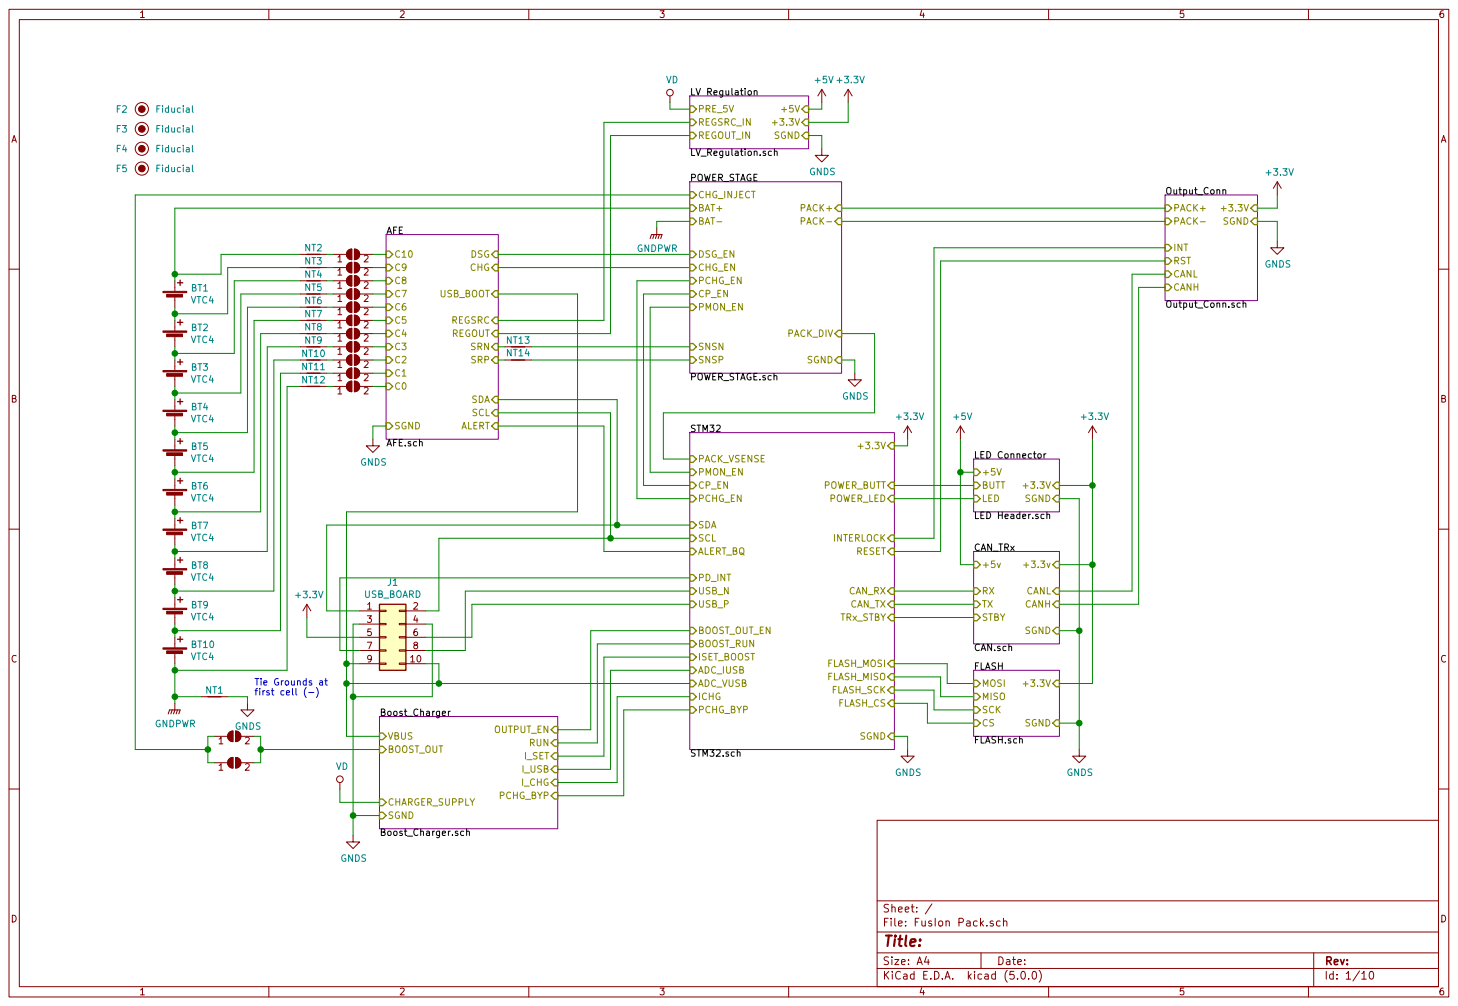
[picture p18: page 1]

LED Connector LED Header.sch

USB_BOARD J1 +3.3V

9 | 10

Id: 1/10 Title: File: FusIon Pack.sch Sheet: /

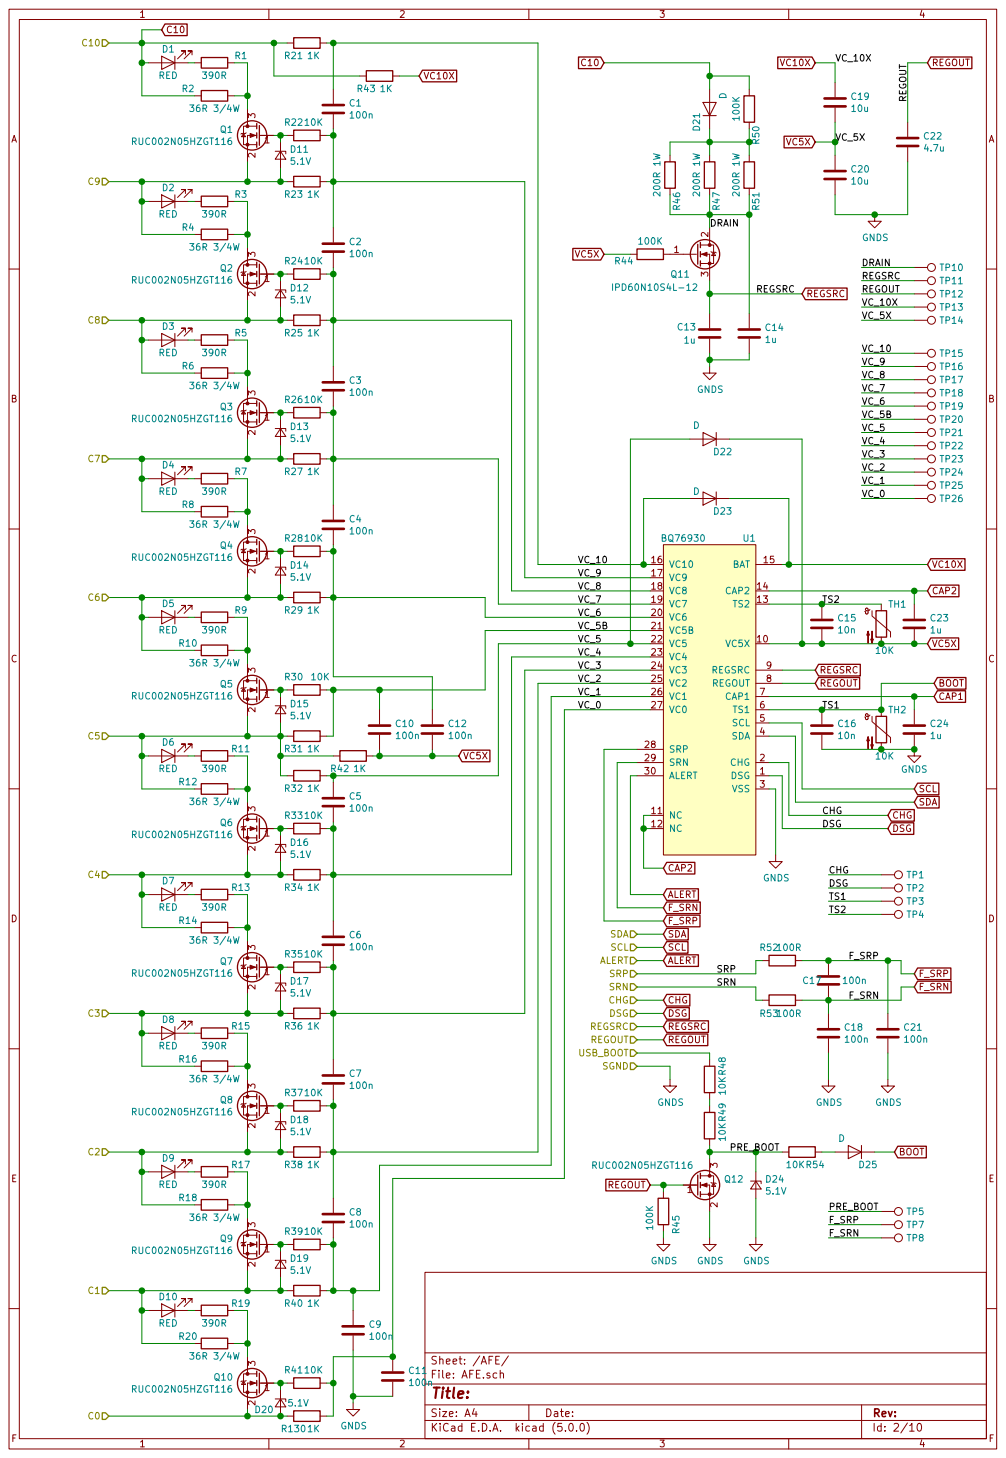
[picture p19: page 2]

Id: 2/10 Title: File: AFE.sch Sheet: /AFE/

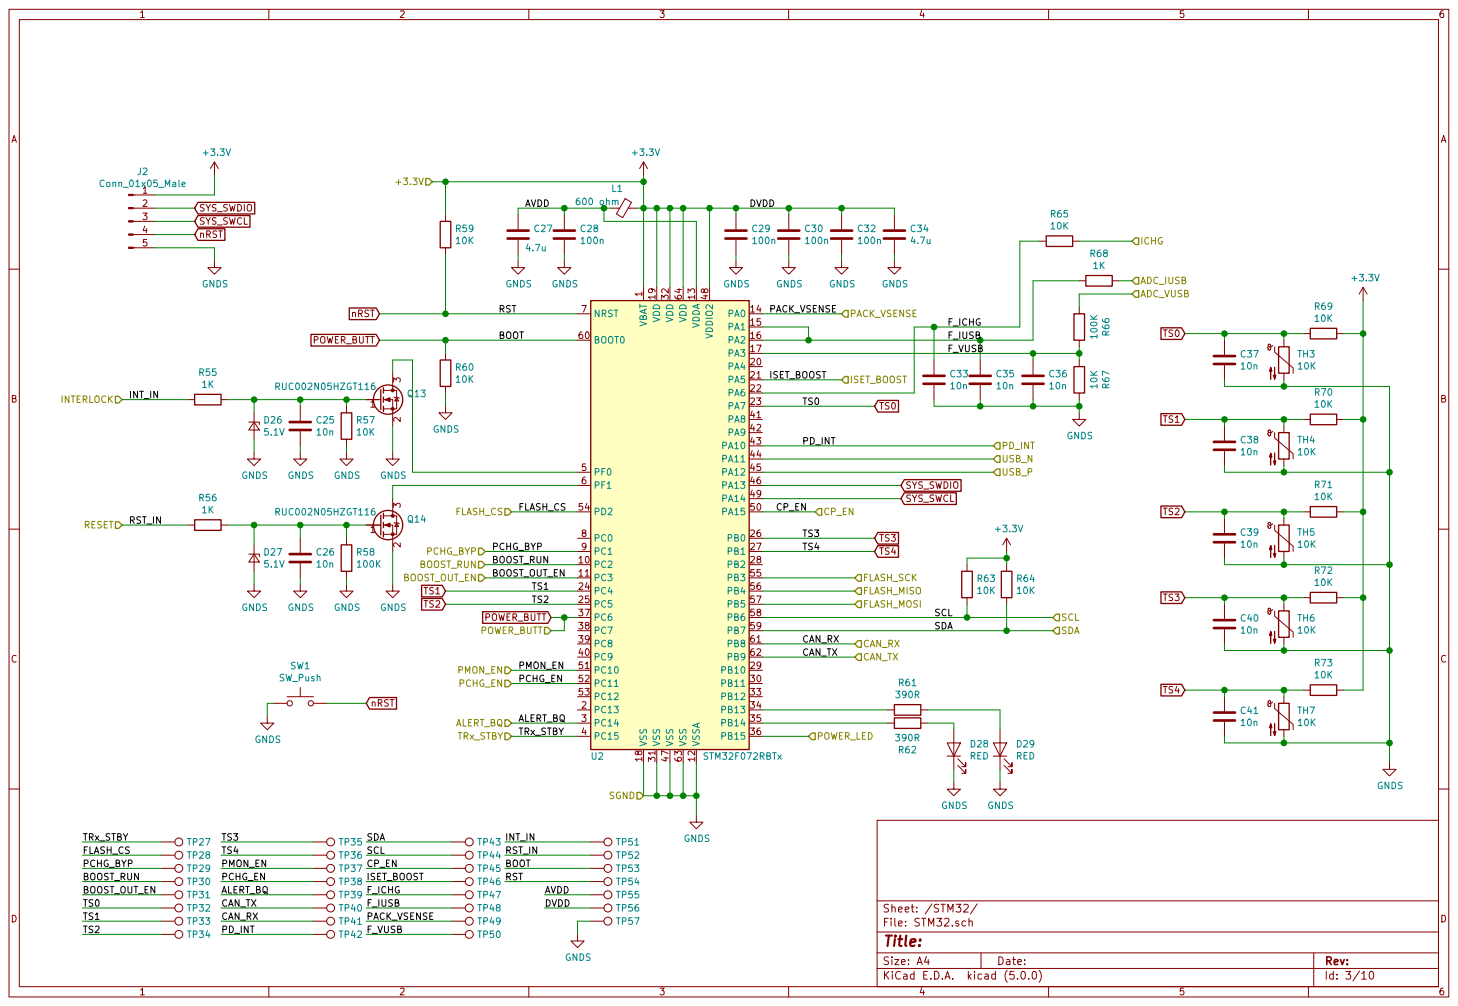
[picture p20: page 3]

1 VDD 19 VDD 32 VDD 64 VDDA 13 VDDIO2 48 VSS 18 VSS 31 VSS 47 VSS 63 VSSA U2 12STM32F072RBTx TS4

Id: 3/10 Title: File: STM32.sch Sheet: /STM32/ GNDS

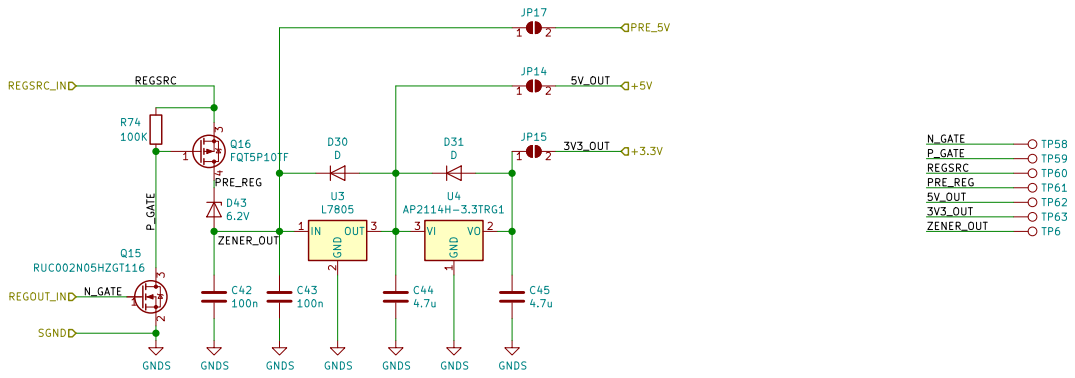
[picture p21: page 4]

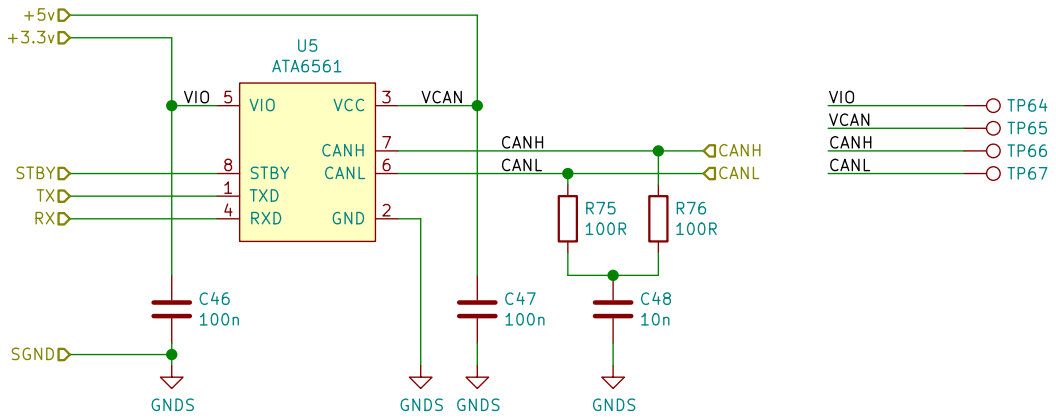
[picture p22: page 5]

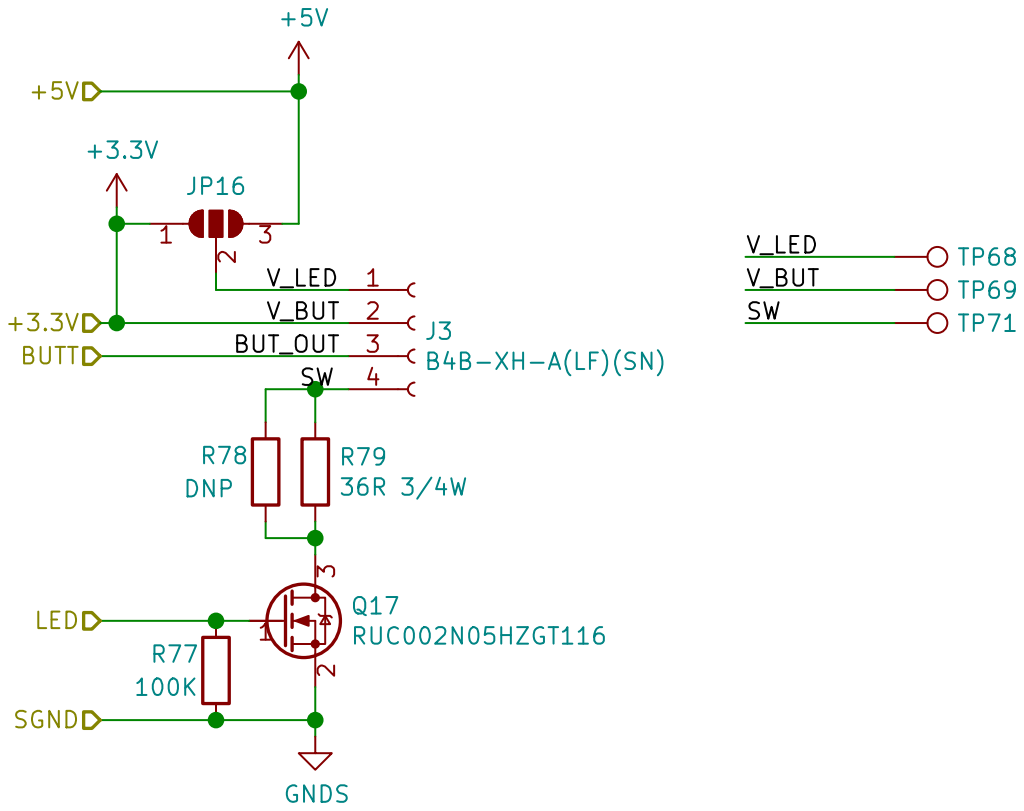
[picture p23: page 6]

Id: 6/10 Title: File: LED Header.sch Sheet: /LED Connector/

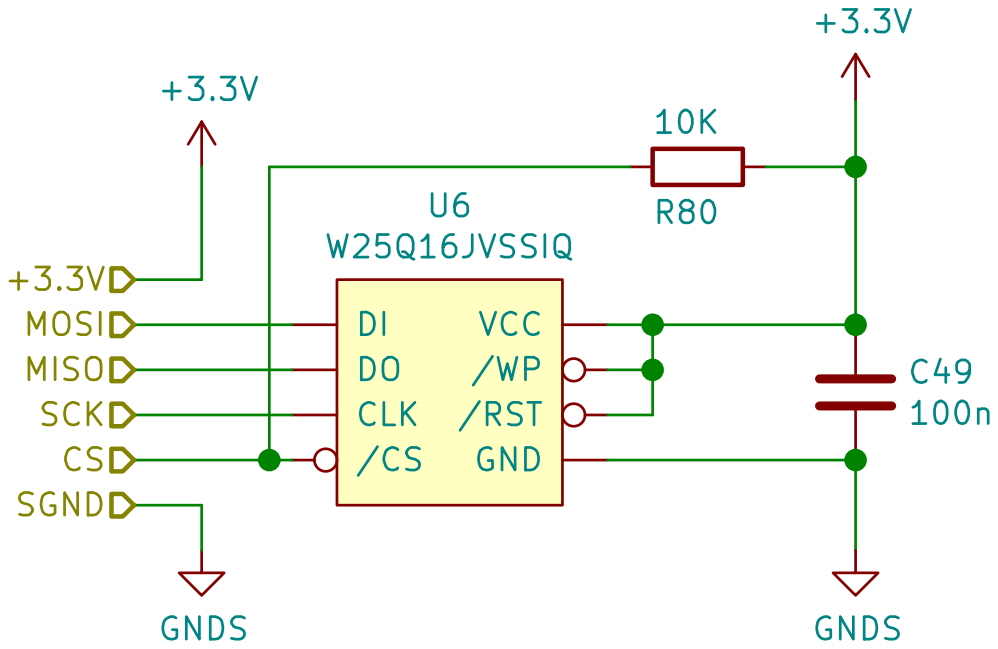
[picture p24: page 7]

Id: 7/10 Title: File: FLASH.sch Sheet: /FLASH/

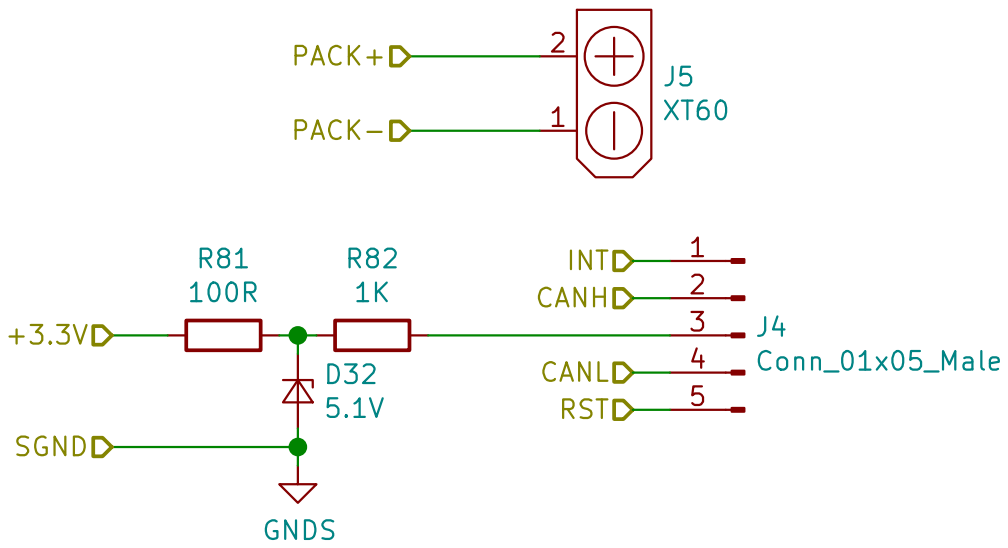
[picture p25: page 8]

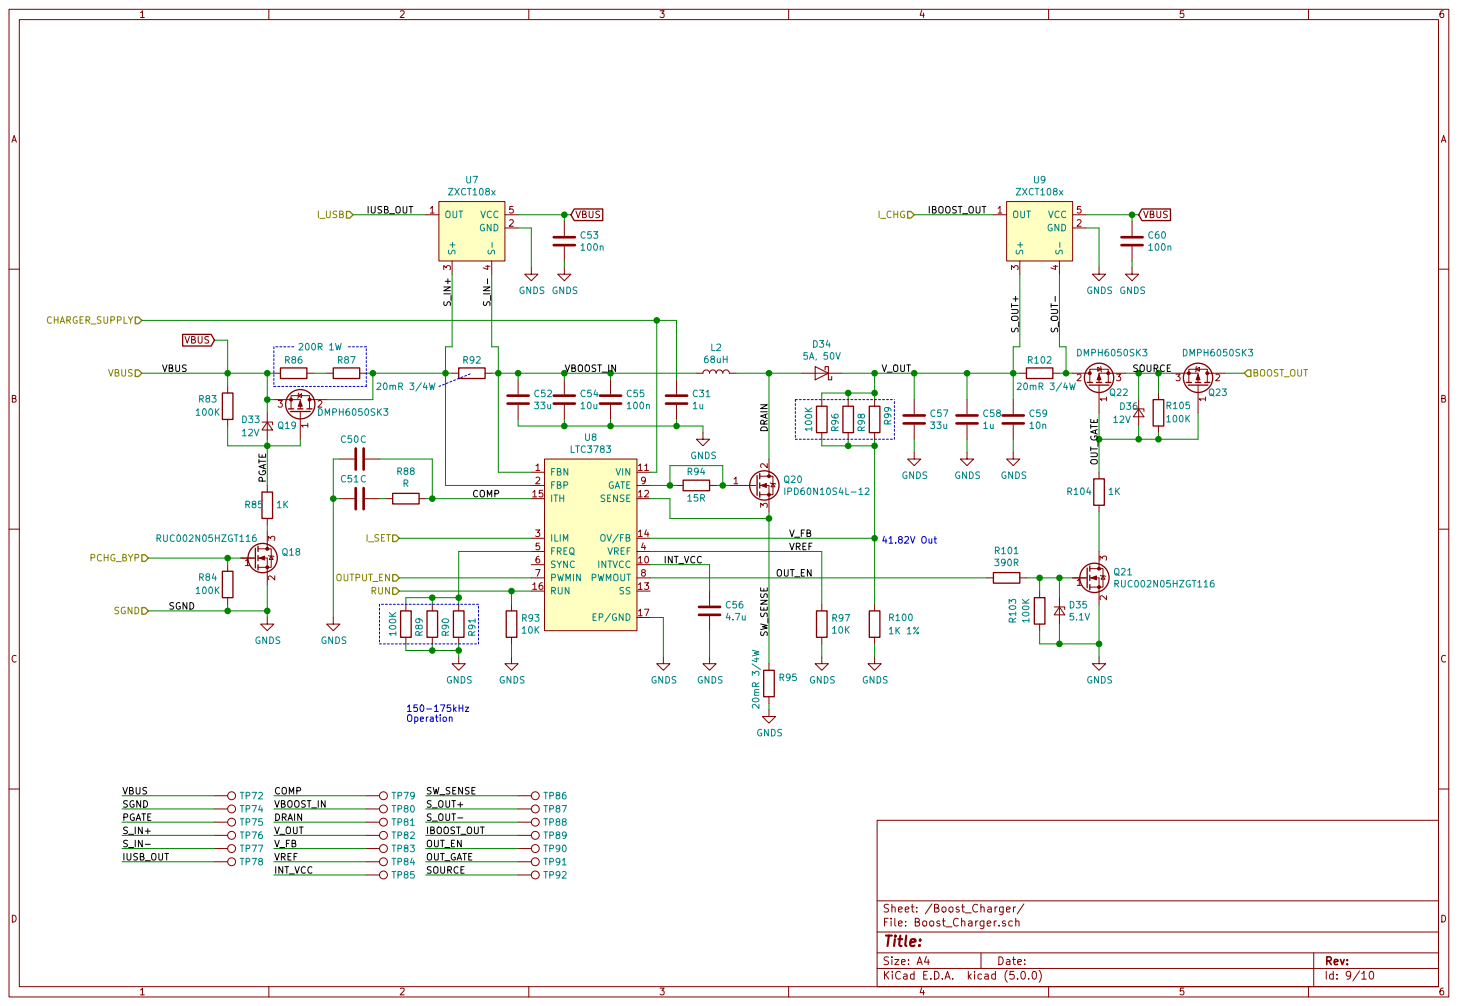
[picture p26: page 9]

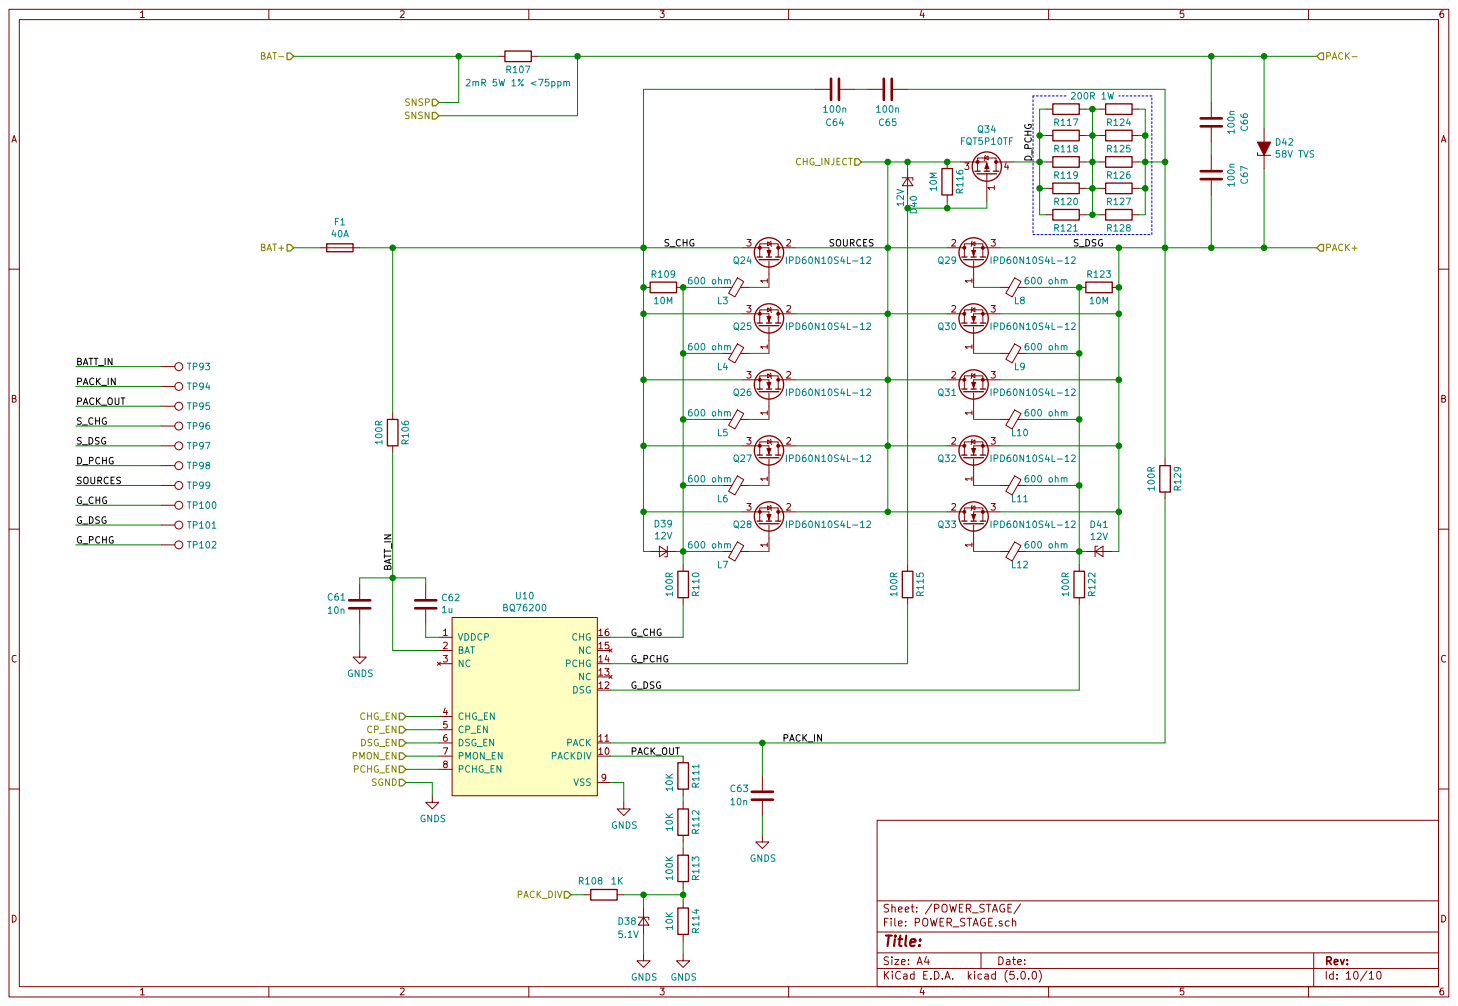
[picture p27: page 10]
