Govish/FusIon-Pack/Renderings/Blank Case PDF.pdf

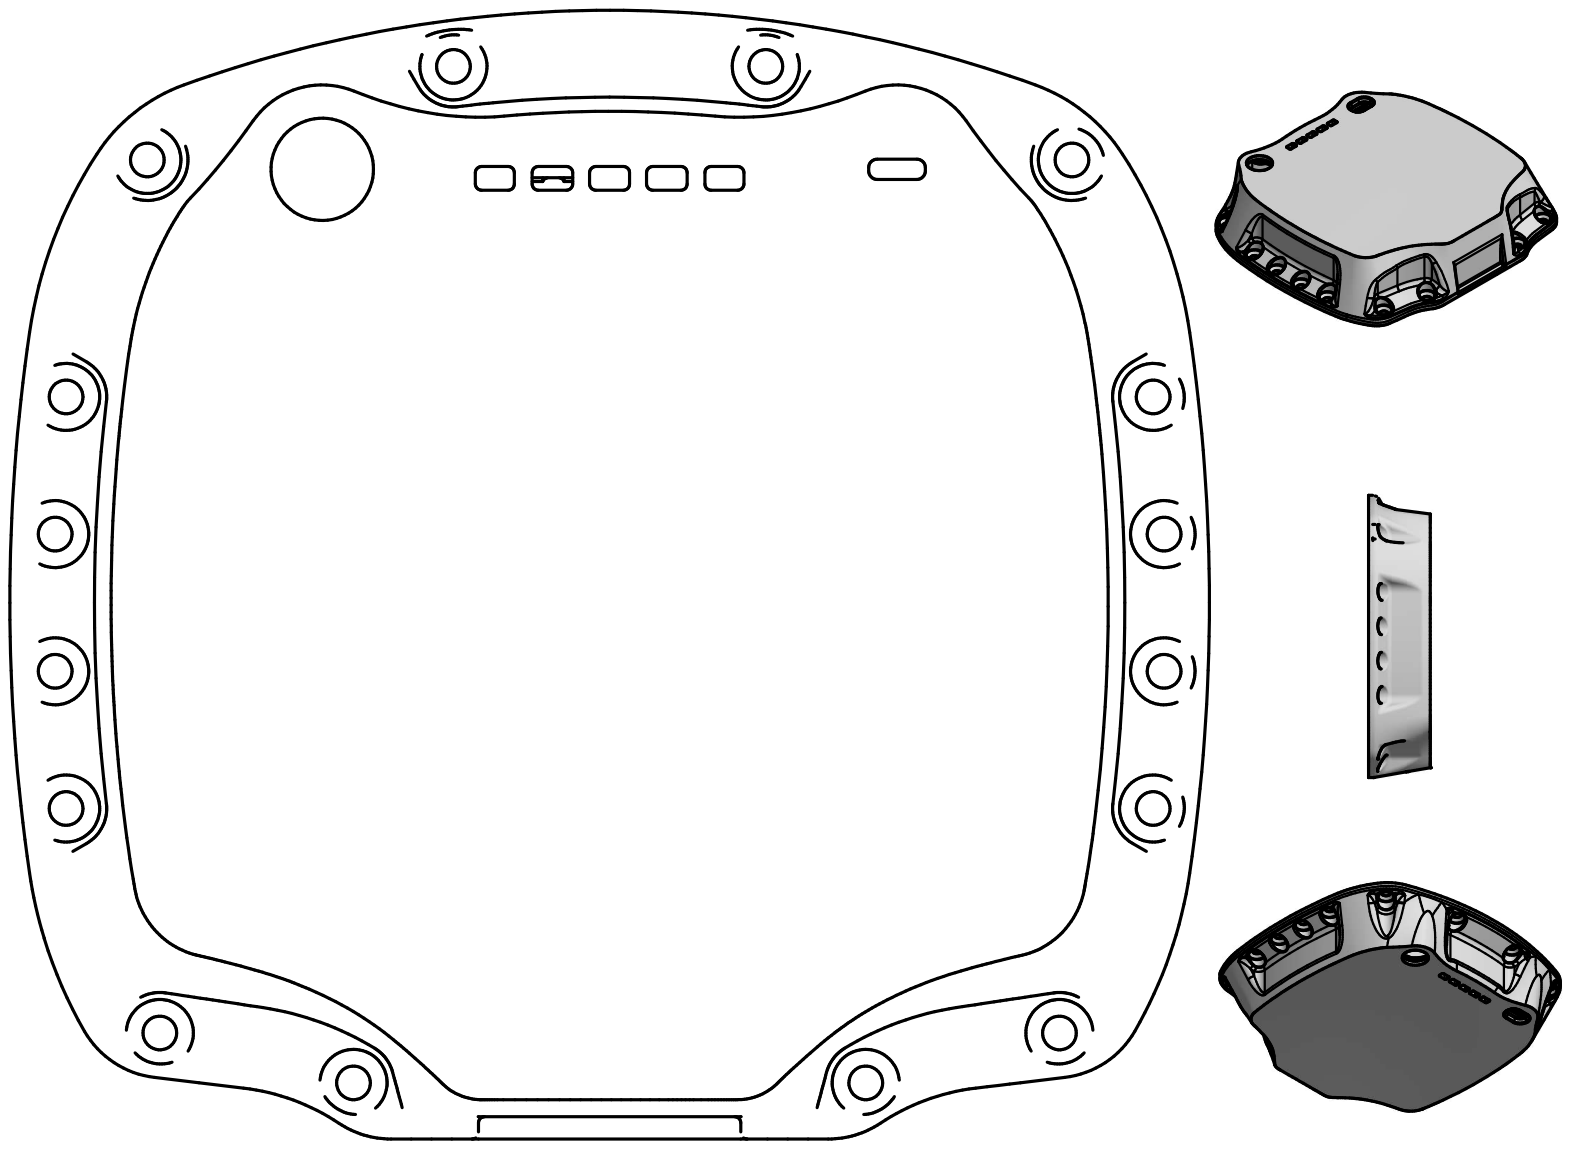
[picture p28: page 1]
