Govish/FusIon-Pack/REV 0-2 PCB/Fusion USB Daughter Board 0-2/Fusion USB Daughter Board.pdf

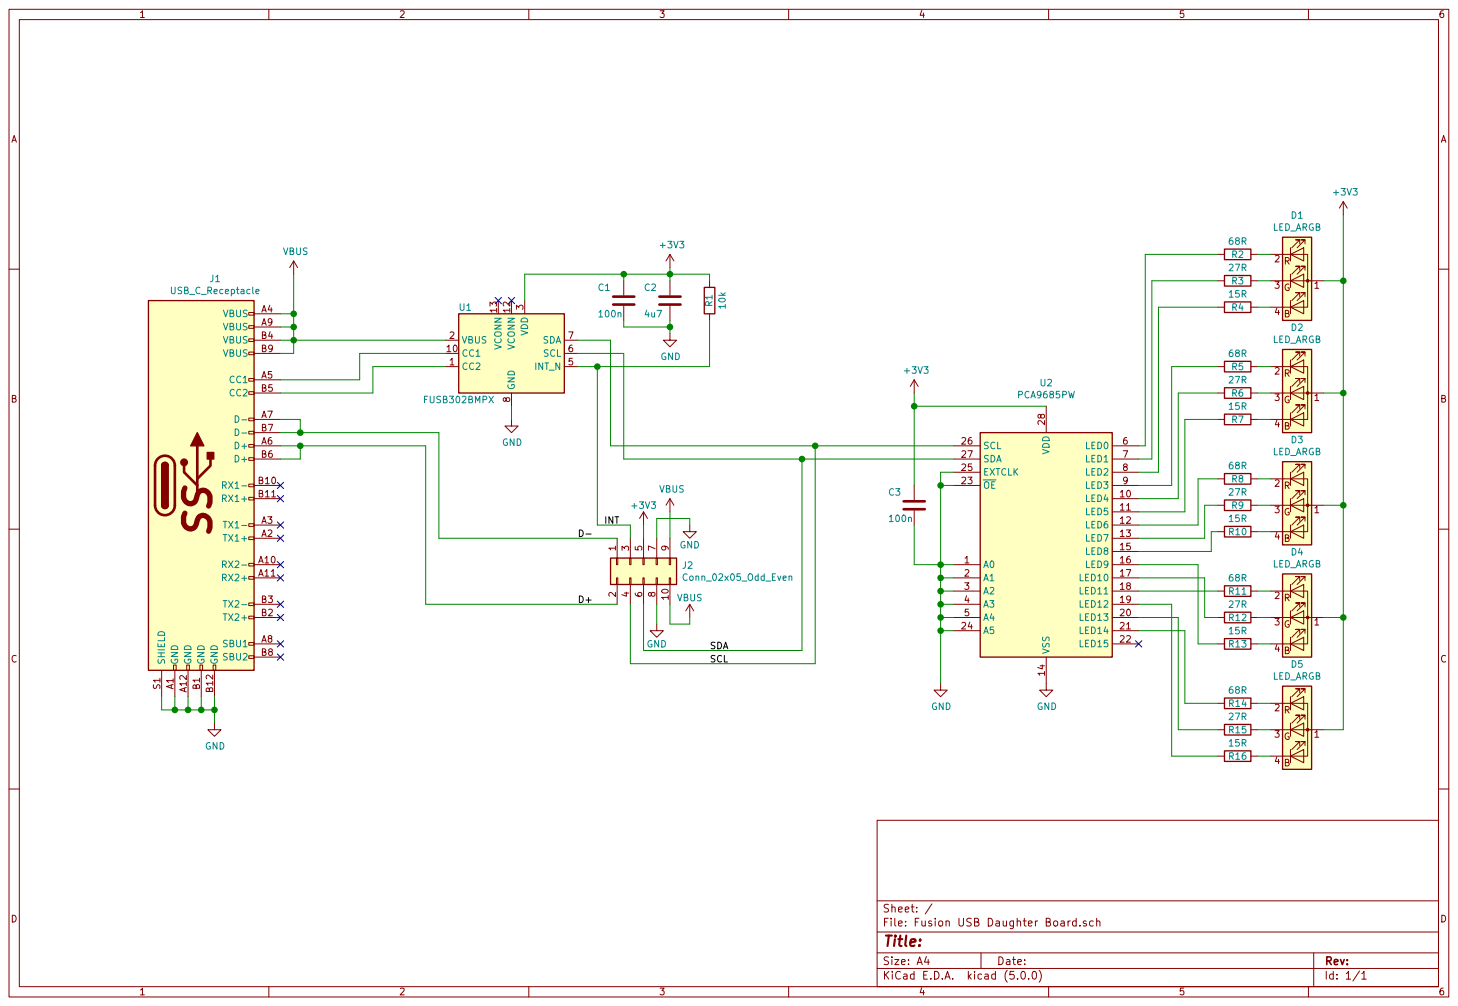
[picture p29: page 1]
