Govish/FusIon-Pack/REV 0-2 PCB/LTC3783_sim.asc

C1: cap; 4.7µ; V=10 Irms=2 Rser=5m Lser=15n
C3: cap; 10n; V=50
C4: cap; 47µ; V=63 Irms=2.6 Rser=29m Lser=10n
C5: cap; 10n; V=75 Irms=2.5 Rser=0.01
C6: cap; 100n; V=50 Irms=2.5 Rser=0.01 Lser=5n
C7: cap; 10µ; V=35 Irms=2.5 Rser=0.01 Lser=22n
C8: cap; 1µ; V=75 Irms=2.5 Rser=0.01
C9: cap; 1µ; V=50 Irms=2.5 Rser=0.01 Lser=10n
D1: schottky; RB088BM100
L1: ind; 22µ; Ipk=6.5 Rser=60m
M1: nmos; BSC440N10NS3
R1: res; 20m; tol=1 pwr=0.75
R2: res; 11k; tol=1
R3: res; 33k; tol=1
R4: res; 1k; tol=1
R5: res; 1k; tol=1
R6: res; 20m; tol=1 pwr=0.75
R7: res; 10k; tol=1
R8: res; 9
U1: LTC3783
V1: voltage; 3.3
V2: voltage; 3.3
V3: voltage; .738
V4: voltage; 9; Rser=0.05
Named nets: V_sw, 0, vin, vind, vout
.tran 100m steady
