Govish/FusIon-Pack/CODE/I2C_Test/Src/main.c

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

/* Includes ------------------------------------------------------------------*/
#include "main.h"

/* USER CODE BEGIN Includes */
#include "pca9685.h"
#include "AFE.h"
/* USER CODE END Includes */

I2C_HandleTypeDef hi2c1;

void SystemClock_Config(void);
static void MX_GPIO_Init(void);
static void MX_I2C1_Init(void);
/**
  * @brief  The application entry point.
  * @retval int
  */
int main(void)
{
  /* MCU Configuration--------------------------------------------------------*/

  /* Reset of all peripherals, Initializes the Flash interface and the Systick. */
  HAL_Init();

  /* Configure the system clock */
  SystemClock_Config();

  /* Initialize all configured peripherals */
  MX_GPIO_Init();
  MX_I2C1_Init();
  /* USER CODE BEGIN 2 */

  pca_wake(&hi2c1);

  HAL_Delay(1000);
  pca_init(&hi2c1);
  pca_off(&hi2c1);
  HAL_GPIO_WritePin(LED0_GPIO_Port, LED0_Pin, GPIO_PIN_SET);

  HAL_Delay(1000);
  pca_write_color(&hi2c1, 0, WHITE);
  HAL_GPIO_WritePin(LED1_GPIO_Port, LED1_Pin, GPIO_PIN_SET);

  /* USER CODE END 2 */

  /* Infinite loop */
  /* USER CODE BEGIN WHILE */
  while (1)
  {
	  RGB cDrive = {0, 0, 4096};
    /* USER CODE END WHILE */
	  for(int i = 0; i < 4097; i+=16) {
		  cDrive.r = i;
		  for (uint8_t j = 0; j < 5; j++) {
			  pca_write_color(&hi2c1, j, cDrive);
			  HAL_Delay(1);
		  }
	  }

	  for(int i = 4096; i >= 0; i-=16) {
	  	  cDrive.b = i;
	  	  for (uint8_t j = 0; j < 5; j++) {
	  		  pca_write_color(&hi2c1, j, cDrive);
	  		  HAL_Delay(1);
	  	  }
	  }

	  for(int i = 0; i < 4097; i+=16) {
		  cDrive.g = i;
  		  for (uint8_t j = 0; j < 5; j++) {
  			  pca_write_color(&hi2c1, j, cDrive);
  			  HAL_Delay(1);
  		  }
  	  }

  	  for(int i = 4096; i >= 0; i-=16) {
  	  	  cDrive.r = i;
  	  	  for (uint8_t j = 0; j < 5; j++) {
  	  		  pca_write_color(&hi2c1, j, cDrive);
  	  		  HAL_Delay(1);
  	  	  }
  	  }

  	for(int i = 0; i < 4097; i+=16) {
		  cDrive.b = i;
  		  for (uint8_t j = 0; j < 5; j++) {
  			  pca_write_color(&hi2c1, j, cDrive);
  			  HAL_Delay(1);
  		  }
  	  }

  	  for(int i = 4096; i >= 0; i-=16) {
  	  	  cDrive.g = i;
  	  	  for (uint8_t j = 0; j < 5; j++) {
  	  		  pca_write_color(&hi2c1, j, cDrive);
  	  		  HAL_Delay(1);
  	  	  }
  	  }

    /* USER CODE BEGIN 3 */
  }
  /* USER CODE END 3 */
}

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
