Govish/FusIon-Pack/CODE/USB_DFU_Test/Inc/main.h

#define BUTTON_Pin GPIO_PIN_13
#define BUTTON_GPIO_Port GPIOC
#define USART_TX_Pin GPIO_PIN_2
#define USART_TX_GPIO_Port GPIOA
#define USART_RX_Pin GPIO_PIN_3
#define USART_RX_GPIO_Port GPIOA
#define LED_0_Pin GPIO_PIN_5
#define LED_0_GPIO_Port GPIOA
#define LED_1_Pin GPIO_PIN_6
#define LED_1_GPIO_Port GPIOA
#define LED_2_Pin GPIO_PIN_7
#define LED_2_GPIO_Port GPIOA
#define TMS_Pin GPIO_PIN_13
#define TMS_GPIO_Port GPIOA
#define TCK_Pin GPIO_PIN_14
#define TCK_GPIO_Port GPIOA
