Govish/FusIon-Pack/(commit log)

2019-02-22 Pushing initial files for FusIon Pack
    [AFE.sch, Boost MOSFET Dissipation Calcs.xlsx, Boost_Charger.sch, CAN.sch, Estimated BOM Cost.xlsx, FLASH.sch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]
2019-02-26 Update FusIon Pack.xlsx
    [FusIon Pack.xlsx]
2019-04-24 Pushing stuff for Rev II PCB
    [Boost MOSFET Dissipation Calcs.xlsx, FusIon Pack.xlsx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]
2019-04-24 Adding PDF Version of Daughterboard Schematic
2019-04-30 Create Blank Case PDF.pdf
2019-04-30 Pushing PDF Version of Mainboard Schematic
2019-05-04 Pushing some I2C Experiments and calculations for a LV Buck Converter
    [FusIon Pack.xlsx, LV Buck Converter Calcs.xlsx]
2019-05-06 Adding I2C Library for PCA9685
2019-05-07 Updating PCA9685 Test code, correcting mistake in LV Buck converter spec, adding a rough sim for LV Buck
    [LV Buck Converter Calcs.xlsx]
2019-05-19 Failing at making a custom bootloader and testing VCP
    [LV Buck Converter Calcs.xlsx]
2019-06-19 uhhhhhh updates?
    [Buck Converter SubBoard 0-2.kicad_pcb, Buck Converter SubBoard 0-2.sch]
2019-06-20 Pushing Buck Converter Sub Board for 0-2
    [Buck Converter SubBoard 0-2.sch]
2019-06-29 Pushing regulator and interface sub-boards for FlatPack
    [Buck Converter SubBoard 0-2-B_Cu.gbr, Buck Converter SubBoard 0-2-B_Mask.gbr, Buck Converter SubBoard 0-2-B_SilkS.gbr, Buck Converter SubBoard 0-2-Edge_Cuts.gbr, Buck Converter SubBoard 0-2-F_Cu.gbr, Buck Converter SubBoard 0-2-F_Mask.gbr, Buck Converter SubBoard 0-2-F_SilkS.gbr, Buck Converter SubBoard 0-2-NPTH.drl]
2019-09-14 Fixing working tree, pushing a bunch of SubBoards and FlatPack BOM
    [AFE SubBoard 0-2-B_Cu.gbr, AFE SubBoard 0-2-B_Mask.gbr, AFE SubBoard 0-2-B_Paste.gbr, AFE SubBoard 0-2-B_SilkS.gbr, AFE SubBoard 0-2-Edge_Cuts.gbr, AFE SubBoard 0-2-F_Cu.gbr, AFE SubBoard 0-2-F_Mask.gbr, AFE SubBoard 0-2-F_Paste.gbr]
2019-09-24 Pushing BOM updates for FlatPack
    [FlatPack 0-2 BOM.xlsx]
2019-10-20 Adding USB LED SubBoard 0-2
    [FlatPack 0-2 BOM.xlsx, USB LED Daughterboard 0-2.kicad_pcb, USB LED Daughterboard 0-2.sch]
2019-10-21 More work on USB LED SubBoard
    [USB LED Daughterboard 0-2.kicad_pcb, USB LED Daughterboard 0-2.sch]
2019-10-22 More USB LED SubBoard updates
    [USB LED Daughterboard 0-2.kicad_pcb]
2019-10-23 Finishing USB LED Daughterboard
    [USB LED Daughterboard 0-2.kicad_pcb, USB LED Daughterboard 0-2.sch]
2019-10-24 Finishing and "Gerberizing" USB LED SubBoard
    [USB LED Daughterboard 0-2-B_Cu.gbr, USB LED Daughterboard 0-2-B_Mask.gbr, USB LED Daughterboard 0-2-B_SilkS.gbr, USB LED Daughterboard 0-2-Edge_Cuts.gbr, USB LED Daughterboard 0-2-F_Cu.gbr, USB LED Daughterboard 0-2-F_Mask.gbr, USB LED Daughterboard 0-2-F_Paste.gbr, USB LED Daughterboard 0-2-F_SilkS.gbr]
2020-01-09 Minor symbol/footprint reassociation
